tomx4096/hexidecimote/hardware/hdme/hdme_front.png

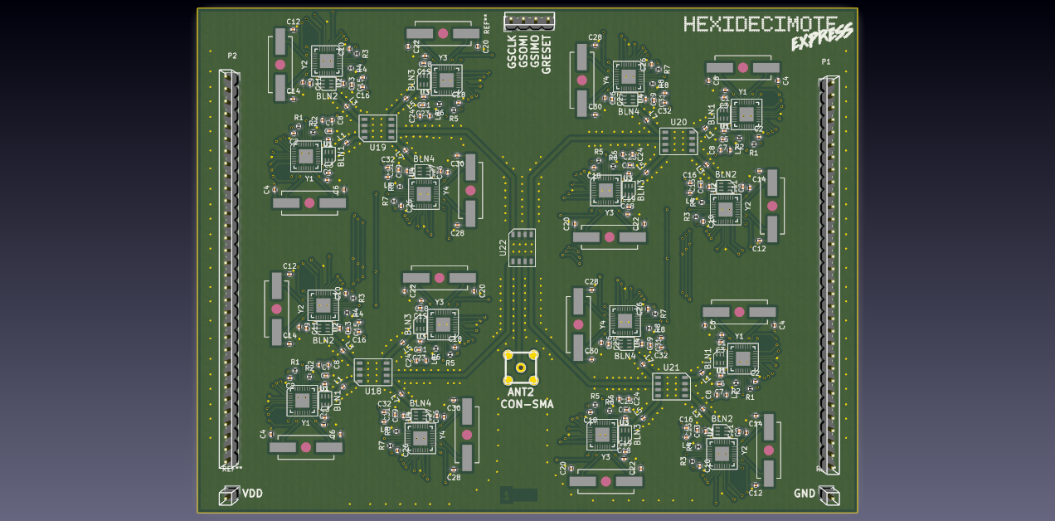
hardware/hdme/hdme_front.png
