tomx4096/hexidecimote/README.md

A device for passive interception of IEEE 802.15.4 packets in the 2.4 GHz band,
on multiple channels at the same time.

Designed in KiCad.
