tomx4096/hexidecimote/docs/multi_channel_wardriving.pdf

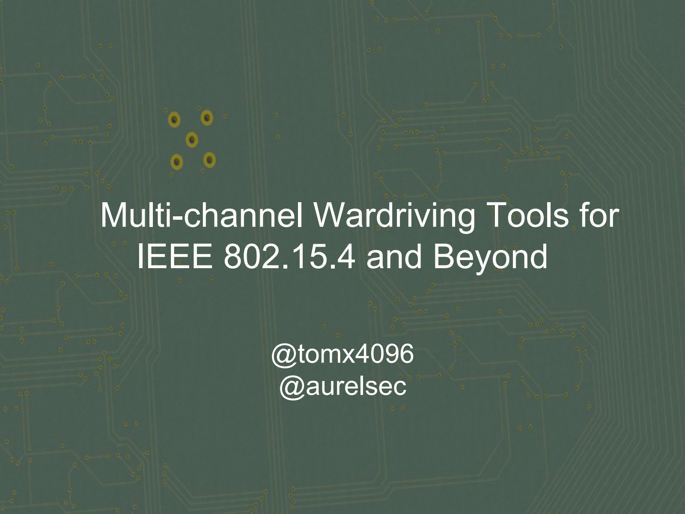
[picture p2: page 1]

# Multi-channel Wardriving Tools for IEEE 802.15.4 and Beyond

# @tomx4096 @aurelsec

# Plan:

# Chapter I: IEEE 802.15.4: Brief Primer & History

# Chapter II: Multi-channel, why, how and how not

# Chapter III: Tomorrow’s Designs, Soon

# Chapter I: IEEE 802.15.For Your Information

IEEE standard for PHY and MAC layers of Short Range,

# Low Rate, Wireless Networks

# (<10meters, 250kbps)

# Home and building automation, industrial

control, Healthcare, smart meters IoT..

# Chapter I: IEEE 802.15.For Your Information

IEEE standard for PHY and MAC layers of Short Range,

# Low Rate, Wireless Networks

# (<10meters, 250kbps)

# Home and building automation, industrial

control, Healthcare, smart meters IoT..

# Who uses this?

IEEE standard for PHY and MAC layers of Short Range,

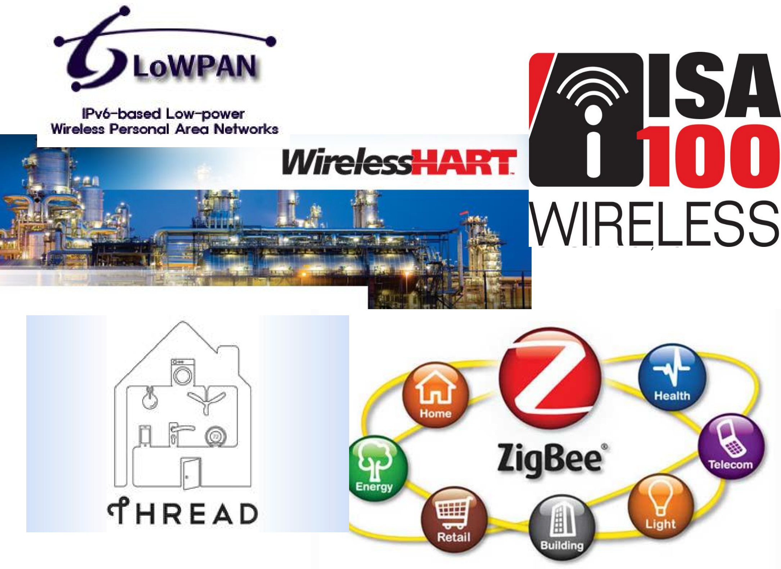
[picture p3: page 5]

Low Rate, Wireless Networks | (<10meters, 250kbps)

Home Automation, Industrial Control, IoT..

# IEEE 802.15.4 In the News

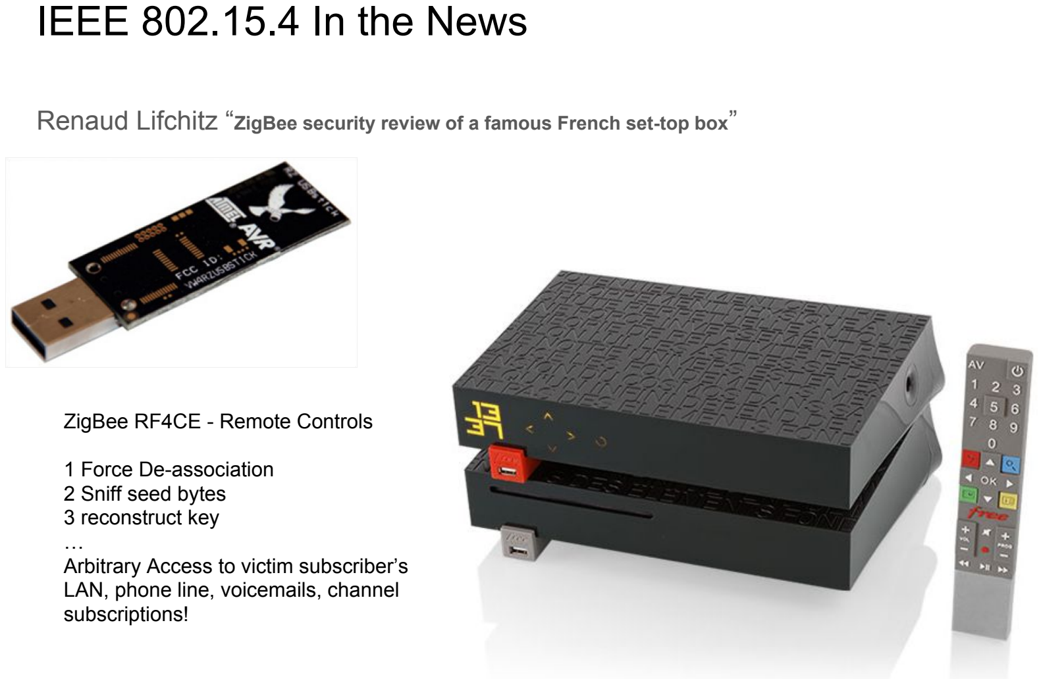
[picture p4: page 6]

Renaud Lifchitz “ZigBee security review of a famous French set-top box”

ZigBee RF4CE - Remote Controls

1 Force De-association
2 Sniff seed bytes
3 reconstruct key
…
Arbitrary Access to victim subscriber’s LAN, phone line, voicemails, channel subscriptions!

# IEEE 802.15.4 In the News

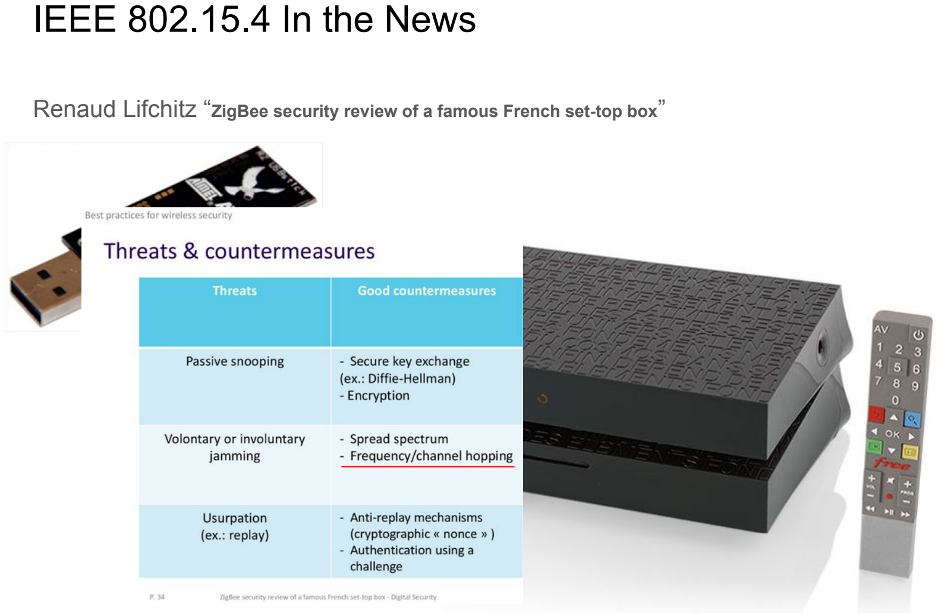
[picture p5: page 7]

Renaud Lifchitz “ZigBee security review of a famous French set-top box”

# Chapter I: IEEE 802.15.For Your Information

IEEE standard for PHY and MAC layers of Short Range,

# Low Rate, Wireless Networks

# (<10meters, 250kbps)

# Home and building automation, industrial

control, Healthcare, smart meters IoT..

# Why not 802.11? Why not bluetooth?

# IEEE 802.15.4 Features

## Simplicity <--> Good Economy ($, time and MWh)

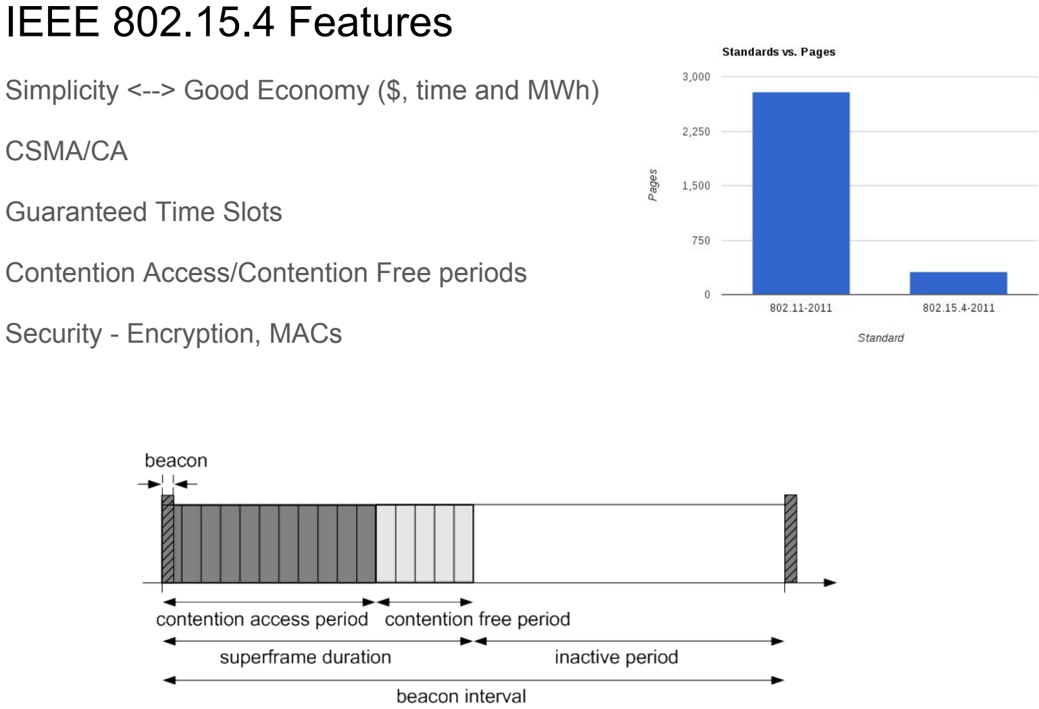
[picture p6: page 9]

## CSMA/CA

## Guaranteed Time Slots

## Contention Access/Contention Free periods

## Security - Encryption, MACs

# Chapter II: Multi-channel Motivation

## 1989 I want it all

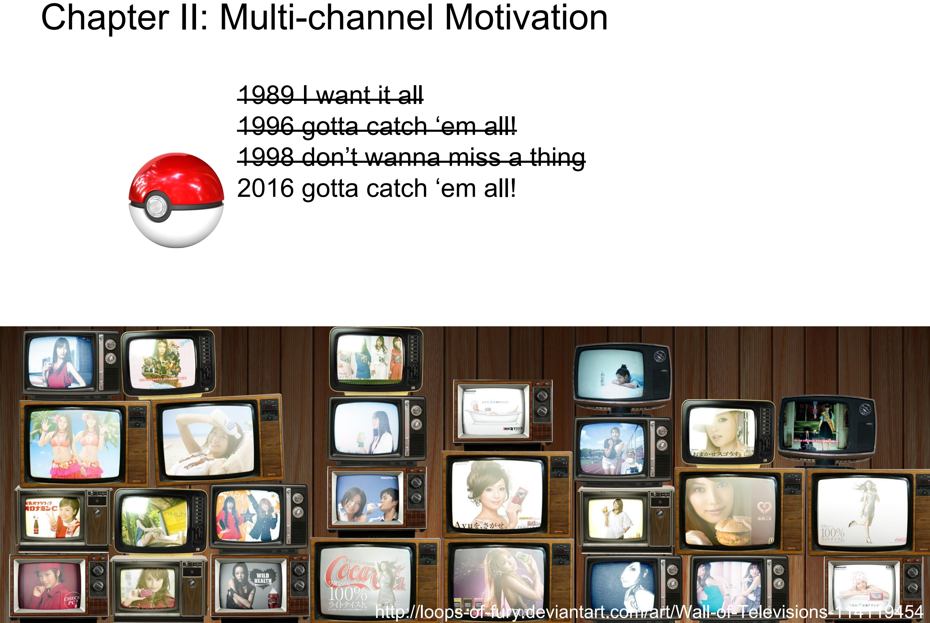
[picture p7: page 10]

http://loops-of-fury.deviantart.com/art/Wall-of-Televisions-114119454

## 1996 gotta catch ‘em all! 1998 don’t wanna miss a thing 2016 gotta catch ‘em all!

# Multi-channel Motivation

## Typical Wardriving Scenario:

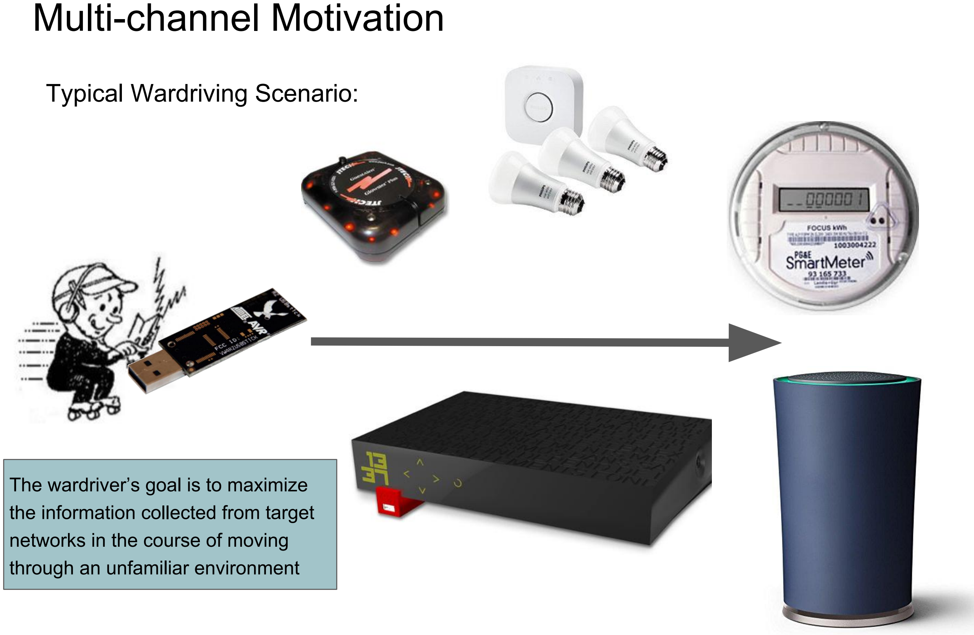
[picture p8: page 11]

http://loops-of-fury.deviantart.com/art/Wall-of-Televisions-114119454

The wardriver’s goal is to maximize the information collected from target networks in the course of moving through an unfamiliar environment

# Multi-channel Motivation

## Typical Wardriving Scenario:

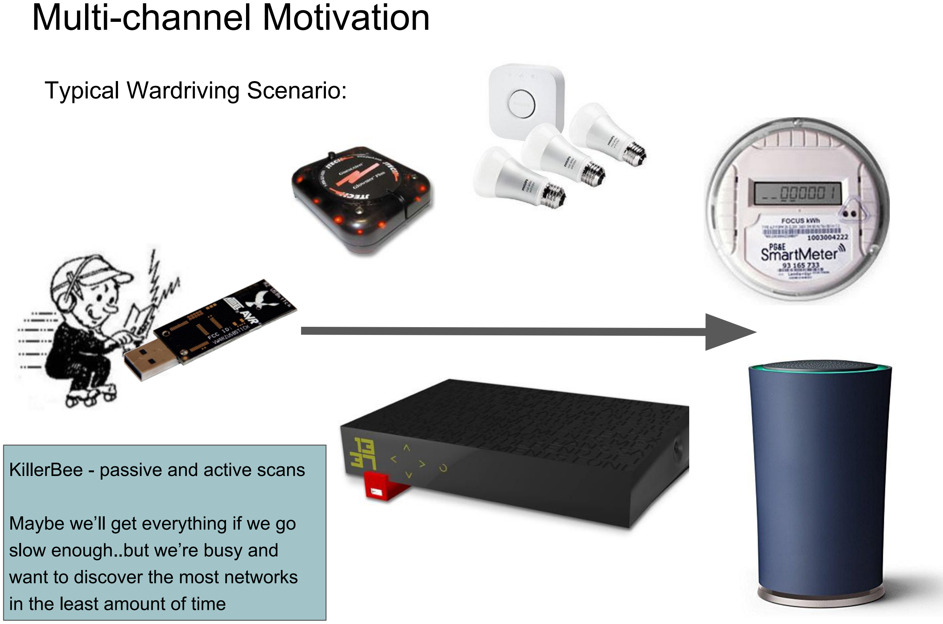
[picture p9: page 12]

http://loops-of-fury.deviantart.com/art/Wall-of-Televisions-114119454

KillerBee - passive and active scans

Maybe we’ll get everything if we go slow enough..but we’re busy and want to discover the most networks in the least amount of time

# Multi-channel Motivation:

http://loops-of-fury.deviantart.com/art/Wall-of-Televisions-114119454

# Low Rate wireless networks -> quieter protocols, fewer messages

# Mobility of wardrivers through short range -> Time spent “in range” is reduced

# Channel scanning -> Is NOT the most effective use of this limited time

# Channel hopping protocols -> Make our precious time even less effective!

## Every-channel sniffing improves our chance of stumbling upon new networks

# Multi-channel Motivation

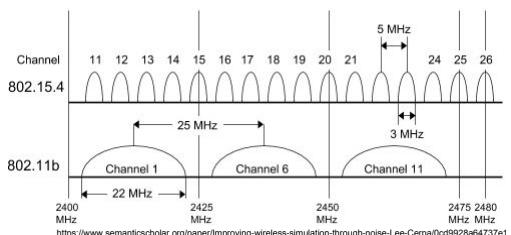
[picture p10: figure]

http://loops-of-fury.deviantart.com/art/Wall-of-Televisions-114119454https://www.semanticscholar.org/paper/Improving-wireless-simulation-through-noise-Lee-Cerpa/0cd9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

16 channels

80 MHz chunk of bandwidth

# What can we do?

## Build a cluster of receivers

## Use an SDR or a cluster of SDRs

## Build a new device

# Multi-channel Tradition

## Ban et al. (2007): Implementation of IEEE 802.15. 4 packet analyzer

## L. Choong (2009): Multi-channel IEEE 802.15. 4 packet capture using software defined radio

## Josh Wright. (2011): Killerbee: practical zigbee exploitation framework

## Speers et al. (2011): Api-do: Tools for Zig-Bee and 802.15. 4 Security Auditing

## Goodspeed et al. (2012): Api-do: Tools for exploring the wireless attack surface in smart meters

## Yoo et al. (2014): Multi-channel packet-analysis system based on IEEE 802.15. 4 packet-capturing modules

# What can we do?

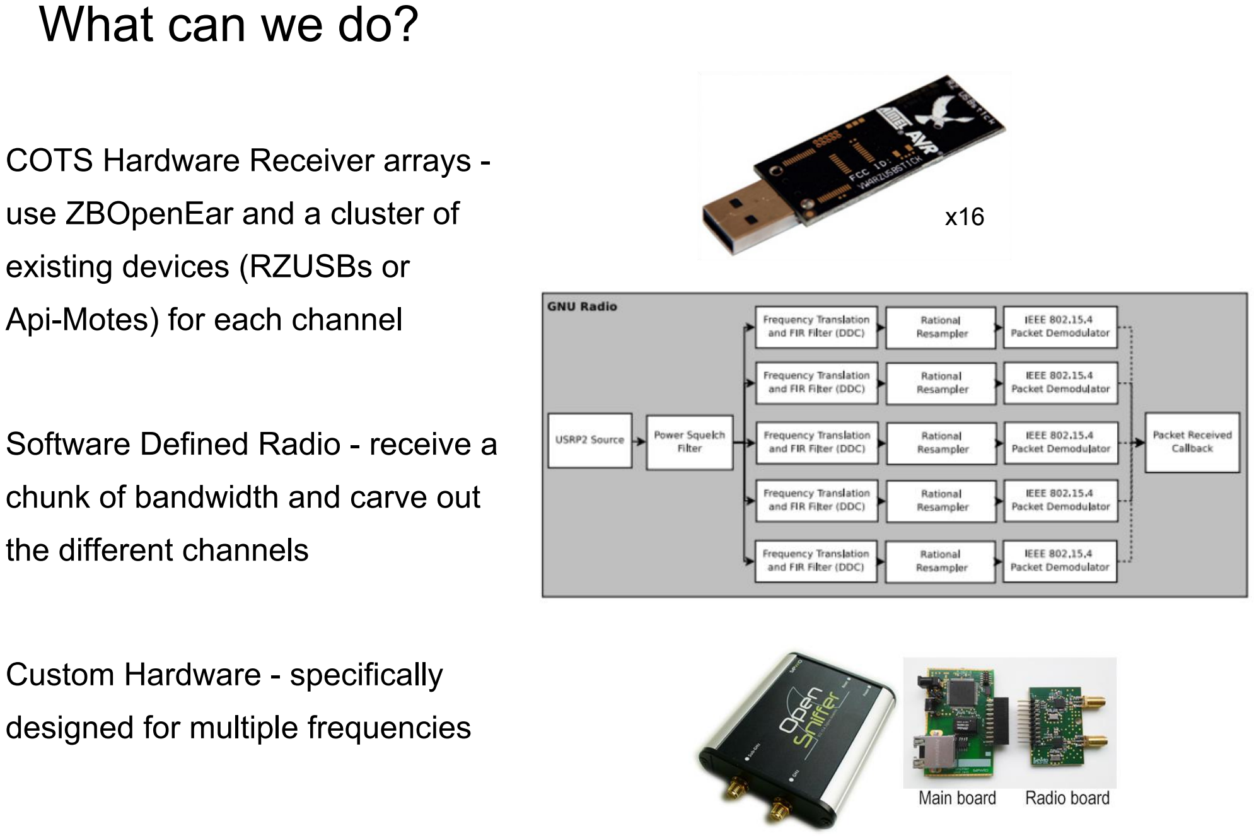
[picture p11: page 17]

## COTS Hardware Receiver arrays -

## use ZBOpenEar and a cluster of

## existing devices (RZUSBs or

## Api-Motes) for each channel

## Software Defined Radio - receive a

## chunk of bandwidth and carve out

## the different channels

## Custom Hardware - specifically

## designed for multiple frequencies

x16

# How about a hardware cluster?

## Simple, gets the job done

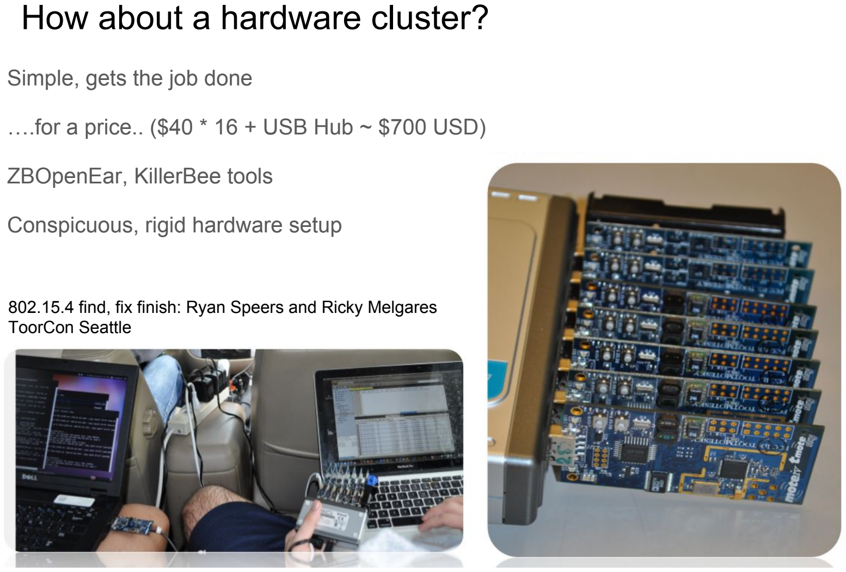
[picture p12: page 18]

## ….for a price.. ($40 * 16 + USB Hub ~ $700 USD)

## ZBOpenEar, KillerBee tools Conspicuous, rigid hardware setup

802.15.4 find, fix finish: Ryan Speers and Ricky Melgares ToorCon Seattle

# How about SDR?

Hopefully, one day..

## Analog-Digital Conversion is the weak link- dynamic range limits performance of the receiver

## Sampling ~80 MHz of bandwidth well enough to decode packets?

## Large computational effort to

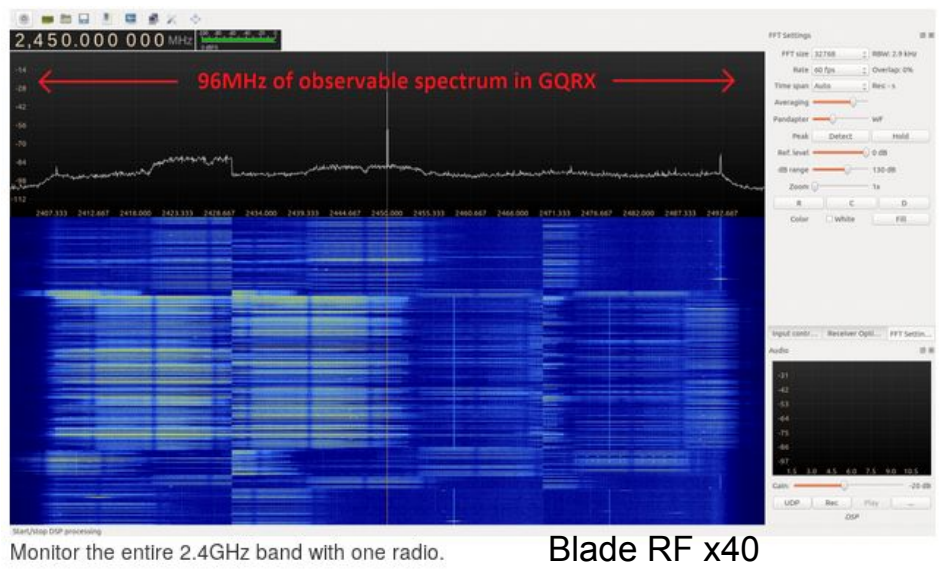
[picture p13: figure]
Blade RF x40

## demod packets

Cost, learning curve, power...

# Spot the SDRs

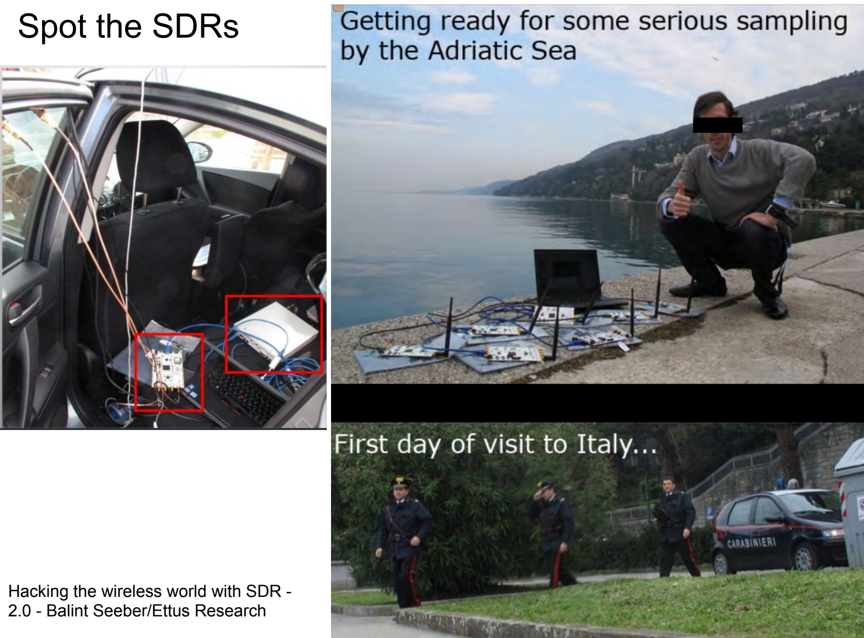
[picture p14: page 20]

Hacking the wireless world with SDR -2.0 - Balint Seeber/Ettus Research

# The GNURadio approach

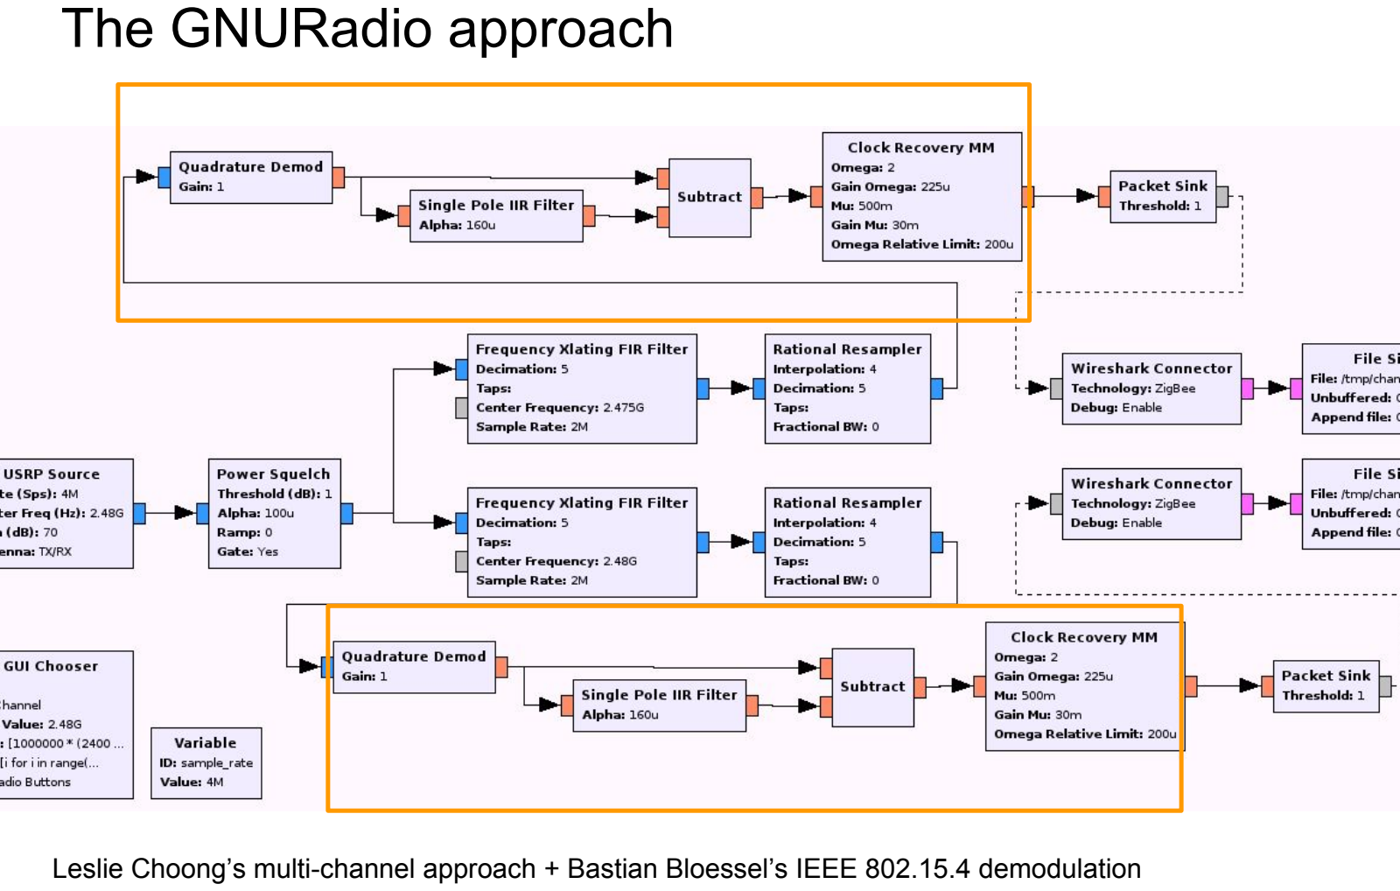
[picture p15: page 21]

Leslie Choong’s multi-channel approach + Bastian Bloessel’s IEEE 802.15.4 demodulation

# How about a new device?

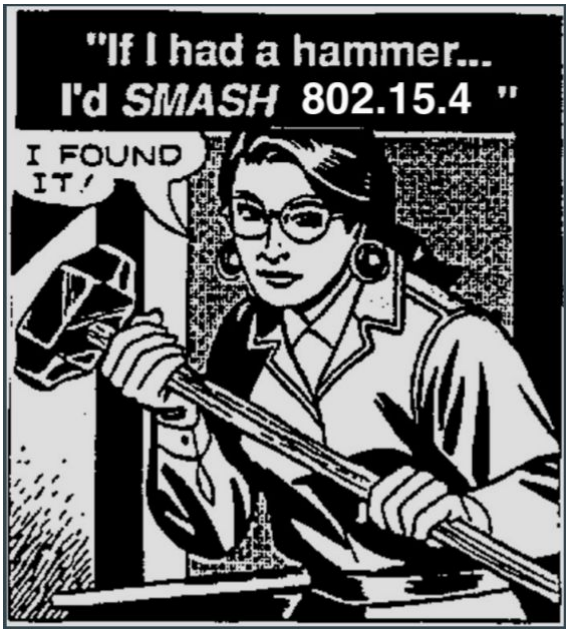
[picture p16: figure]

## Solutions in academic literature are often not portable/ hackable/open source (exception: Api-Mote)

Hardware clusters are big,

## expensive, power hungry

SDRs are big, clunky,

## expensive, power hungry, have a steep learning curve, and limited performance in some cases

# Chapter III: Goals for a new design:

## DG1. Complete simultaneous coverage Parallel reception of all 16 channels of the 2.4 GHz 802.15.4 band

## DG2. Easy to use No learning curve beyond "Plug it in and run KillerBee tools"

## DG3. Relatively cheap The price to beat is 16 RZUSBs + USB hubs

## DG4. Portable and discreet One piece, one antenna, fits in a shoe box, will not capture the wrong attention

## DG5. Extensible

Accommodates peripherals like GPS, WiFi, SD card, etc.

## DG6. Robust performance Good reception indoors, outdoors, with Wifi/Bluetooth interference

## Properties of 802.15.4 multi-channel sniffers

# Api-mote v4 Design

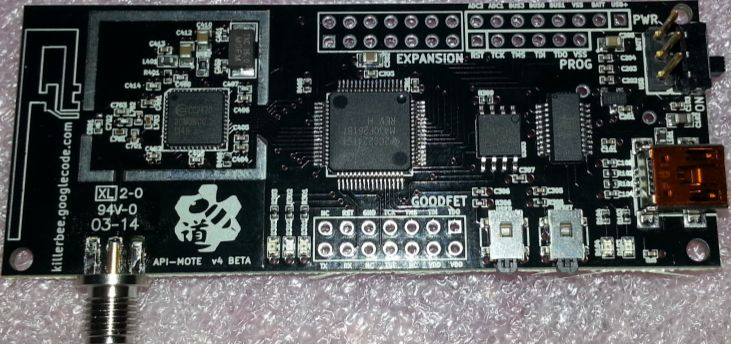
[picture p17: figure]

CC2420 radio Api-mote v4 Design OBSOLETED | On the board but not used by firmware! 10mA active, 5 uA standby

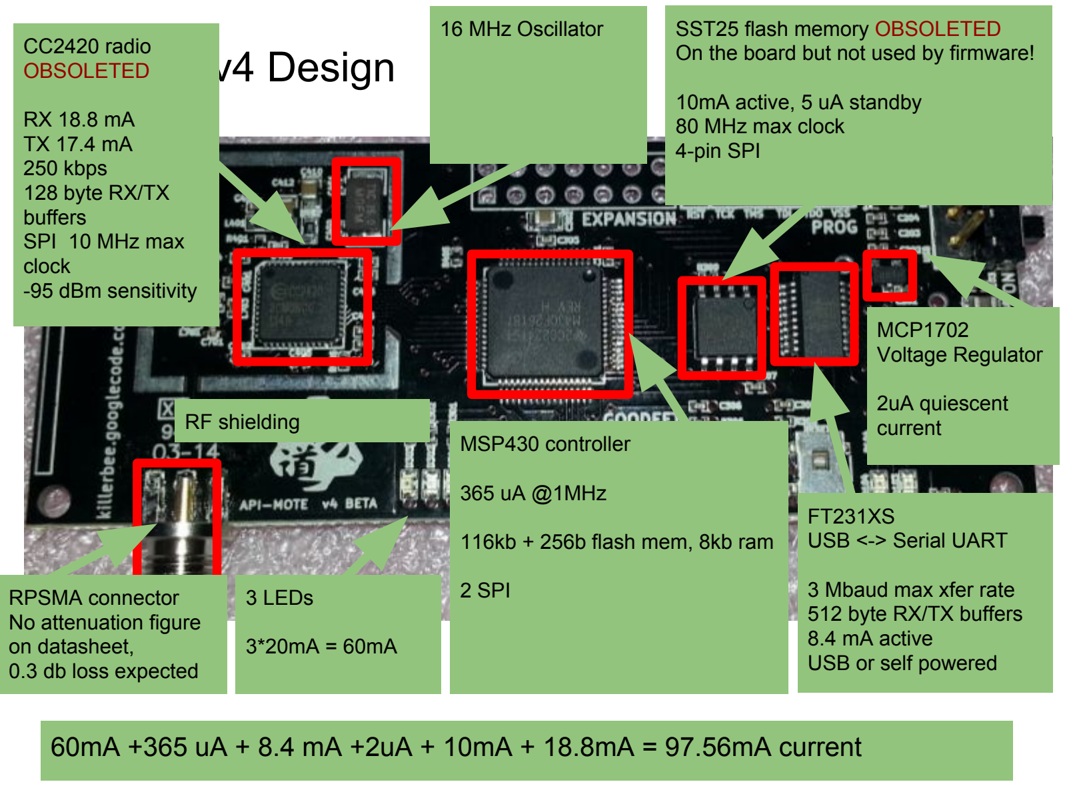
[picture p18: page 26]

| 80 MHz max clock
TX 17.4 mA 250 kbps 128 byte RX/TX buffers SPI 10 MHz max clock -95 dBm sensitivity | 4-pin SPI

RPSMA connector
No attenuation figure
on datasheet,
0.3 db loss expected

RX 18.8 mA

MSP430 controller

365 uA @1MHz

116kb + 256b flash mem, 8kb ram

2 SPI

16 MHz Oscillator | SST25 flash memory OBSOLETED

FT231XS
USB <-> Serial UART

3 Mbaud max xfer rate
512 byte RX/TX buffers
8.4 mA active
USB or self powered

MCP1702
Voltage Regulator

2uA quiescent
current

3 LEDs

3*20mA = 60mA

RF shielding

## 60mA +365 uA + 8.4 mA +2uA + 10mA + 18.8mA = 97.56mA current

# Api-Mote v4 design

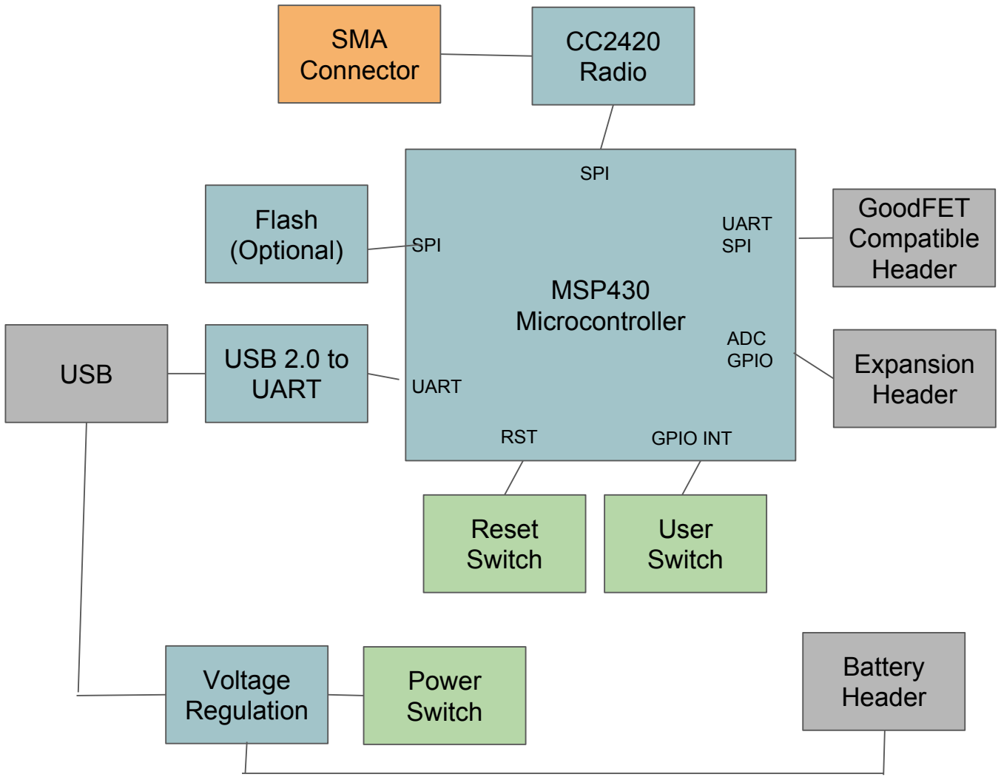
[picture p19: figure]
MSP430 Microcontroller; Flash (Optional); USB 2.0 to UART USB; Voltage Regulation; Power Switch; Reset Switch; User Switch; RST; GPIO INT; Battery Header; Expansion Header; GoodFET Compatible Header; UART SPI; ADC GPIO; UART; SPI; CC2420 Radio; SMA Connector

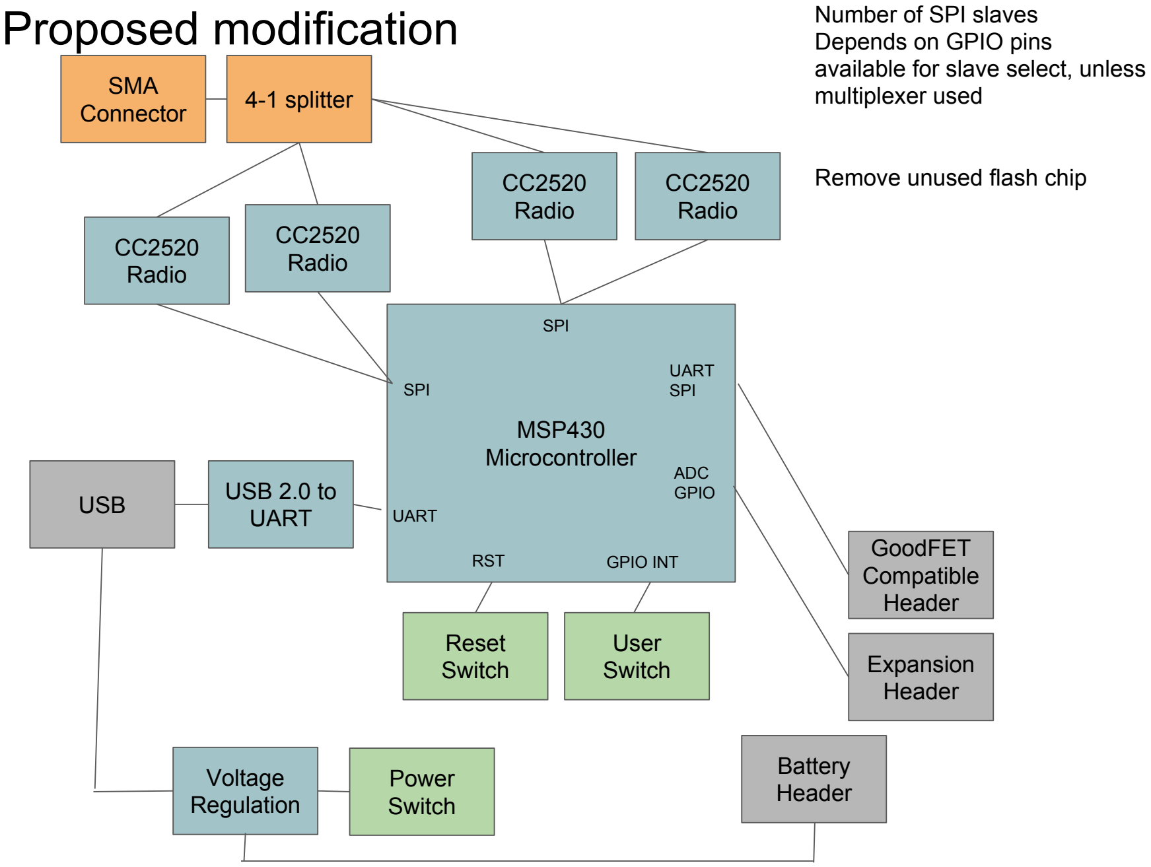
[picture p20: figure]
Proposed modification; MSP430 Microcontroller; USB 2.0 to UART USB; Voltage Regulation; Power Switch; Reset Switch; User Switch; RST; GPIO INT; Battery Header; Expansion Header; GoodFET Compatible Header; UART SPI; ADC GPIO; UART; SPI; CC2520 Radio; SMA Connector; CC2520 Radio CC2520 Radio; Number of SPI slaves Depends on GPIO pins available for slave select, unless multiplexer used; Remove unused flash chip; 4-1 splitter

# Express Design

# How can this be simplified?

# Delegate non-radio functionality to devices off of the board and provide an interface to the radios alone

# Remove microprocessor, USB, JTAG connector, and amplifier. This is the user’s responsibility now!

# More extensible/modular Cheaper to produce Simpler, mitigates risk of catastrophic design mistakes

# Express Design

# How can this be simplified?

# Delegate non-radio functionality to devices off of the board and provide an interface to the radios alone

# Remove microprocessor, USB, JTAG connector, and amplifier. This is the user’s responsibility now!

# More extensible/modular Cheaper to produce Simpler, mitigates risk of catastrophic design mistakes

## Michael Ossmann: Simple RF Circuit Design

## https://www.youtube.com/watch?v=TnRn3Kn_aXg

# RF View:

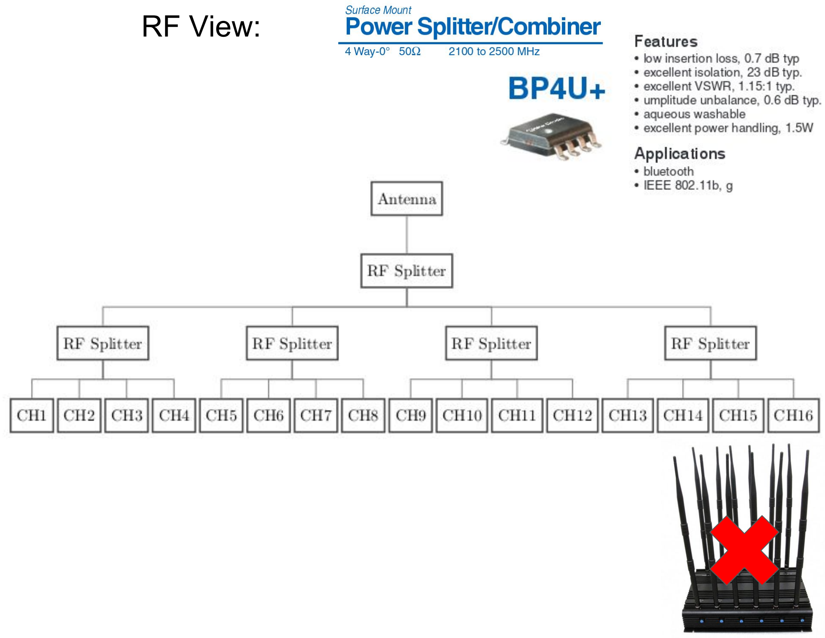
[picture p21: page 31]

# Digital View:

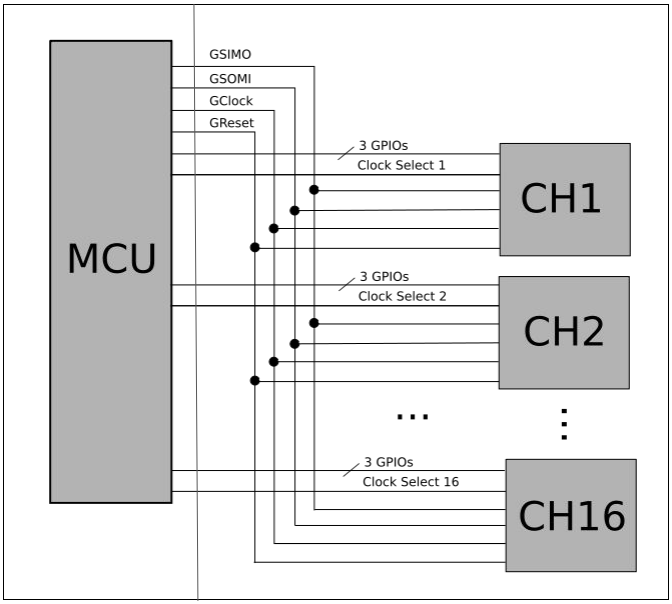
[picture p22: figure]
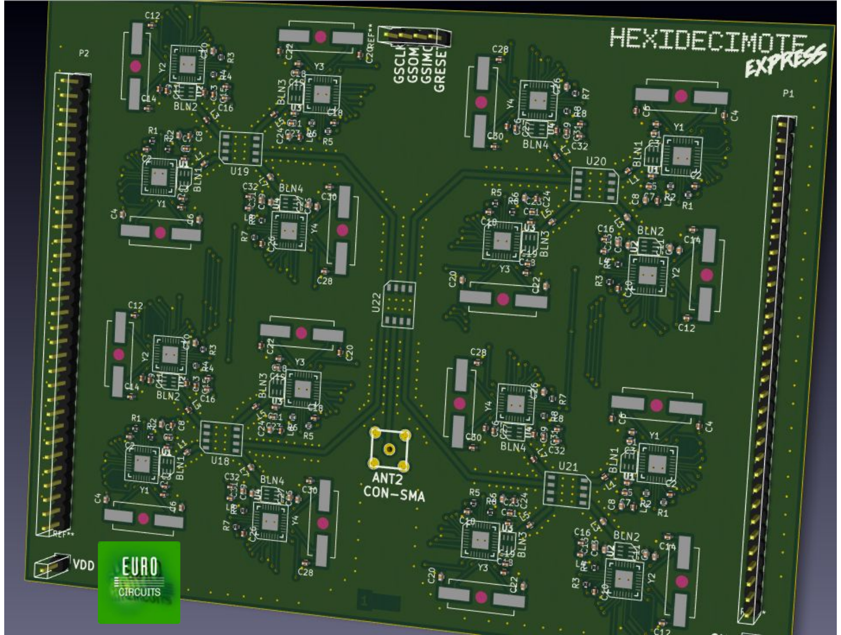
[picture p23: page 33]

# Device Design R3

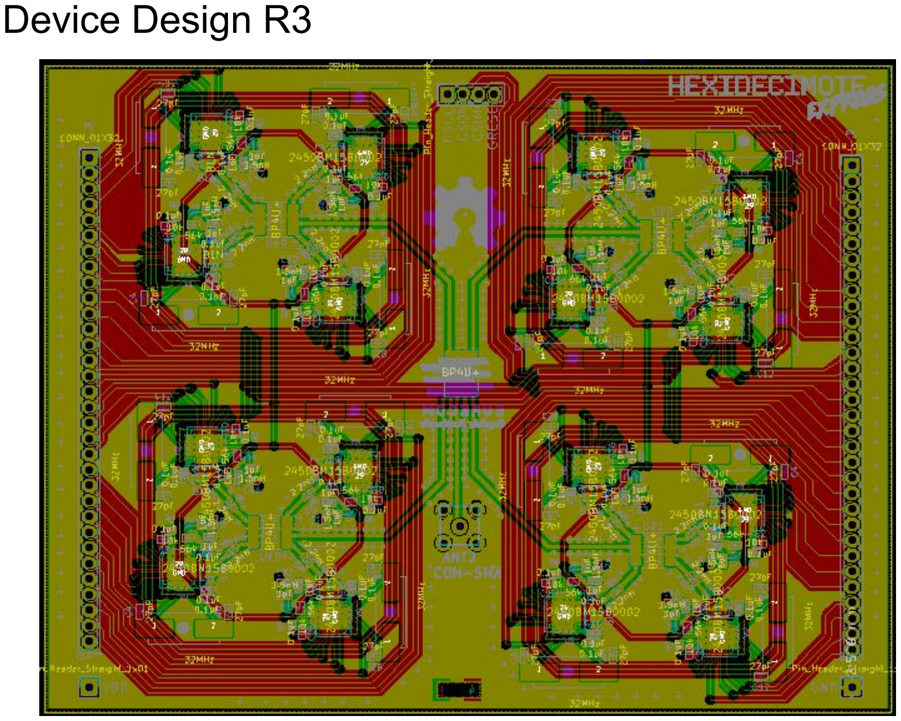
[picture p24: page 34]

# HDME + BBB

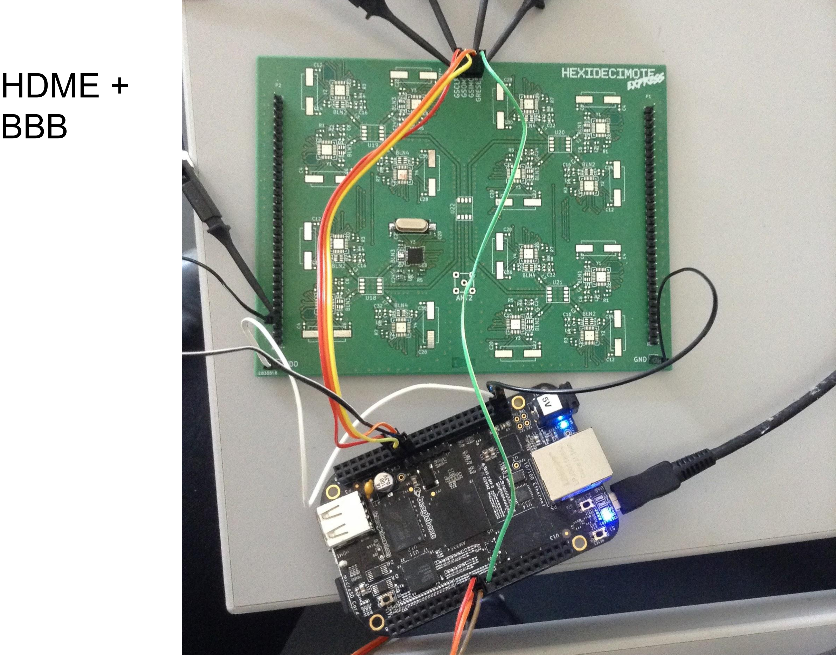
[picture p25: page 35]

# Only 6.25% completion

## 1/16 radios soldered✓

## SPI (CC2520 driver in linux kernel)✓

## wpan-tools compatibility ✓

## ….please contribute!

## github.com/tomx4096

## Packet reception X

## Multi-radio driver X

## Performance testing X

## BBB “cape” form factor X

# Thank you, village people

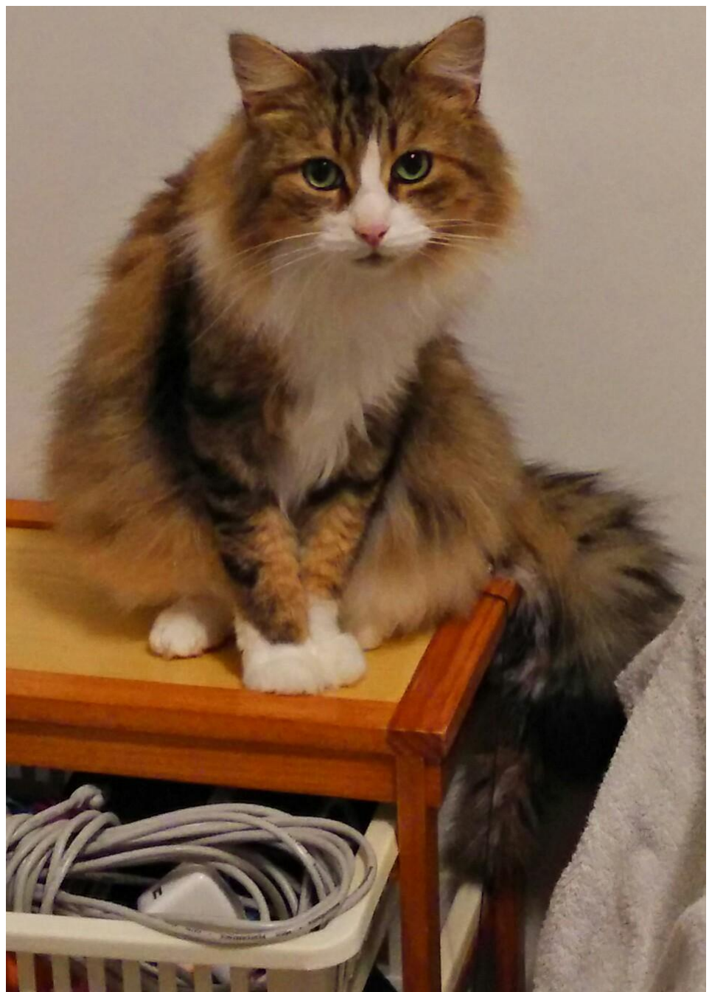
[picture p26: figure]

# Standard and Amendments

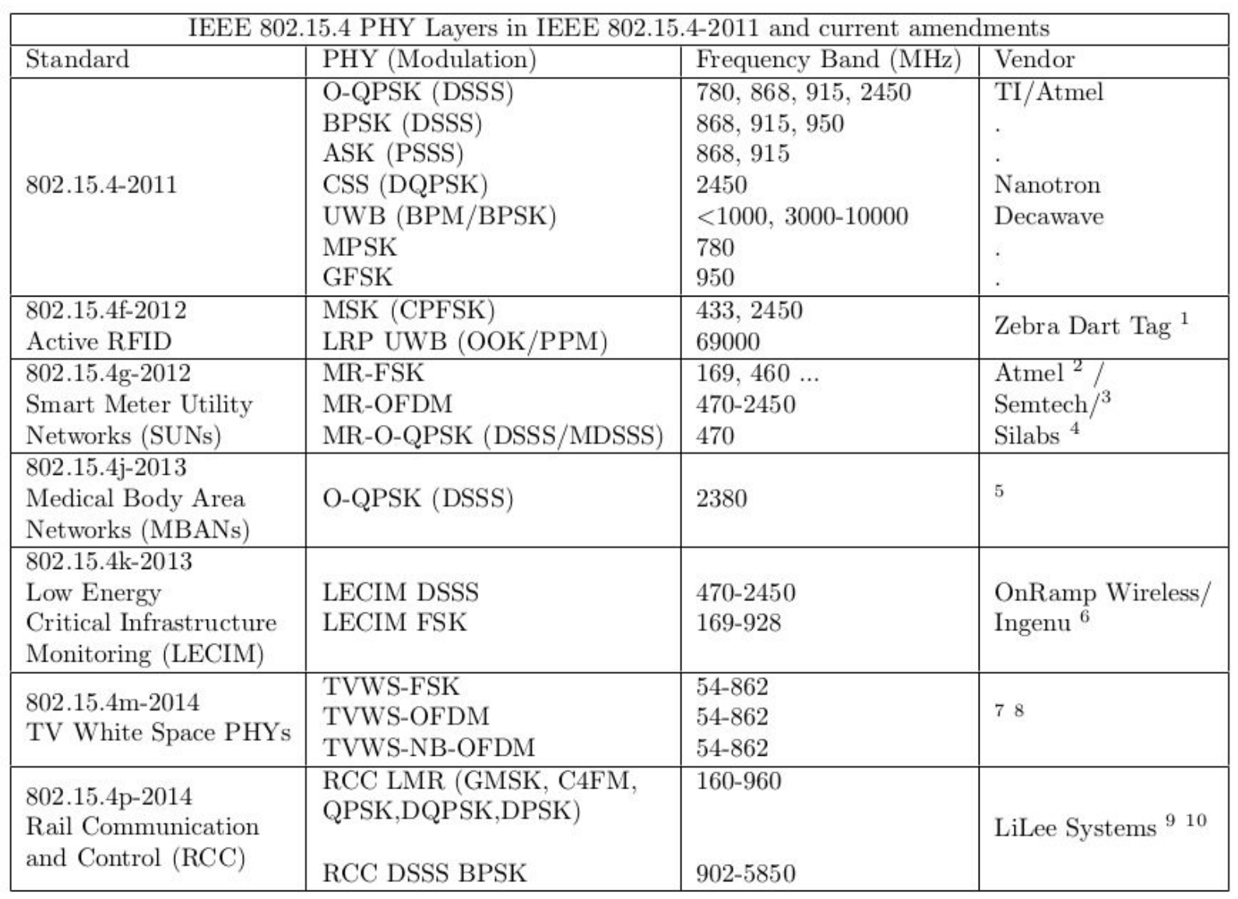
[picture p27: page 38]
