tomx4096/hexidecimote/hardware/hdme/hdme_back.png

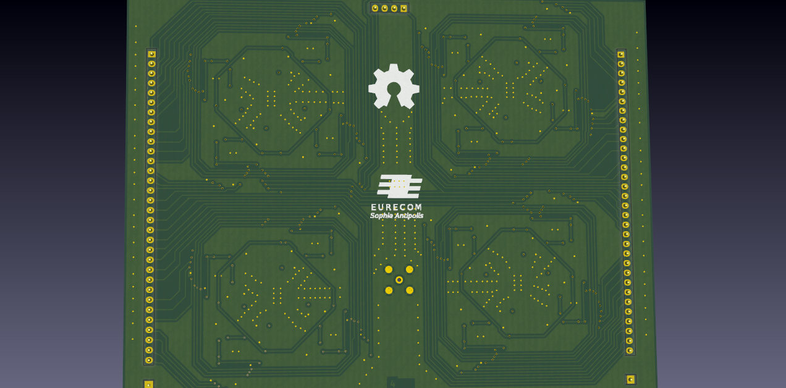
hardware/hdme/hdme_back.png
