tomx4096/hexidecimote/hardware/hdme/hdme.sch

## KiCad design hardware/hdme/hdme.sch (2016-08-08)

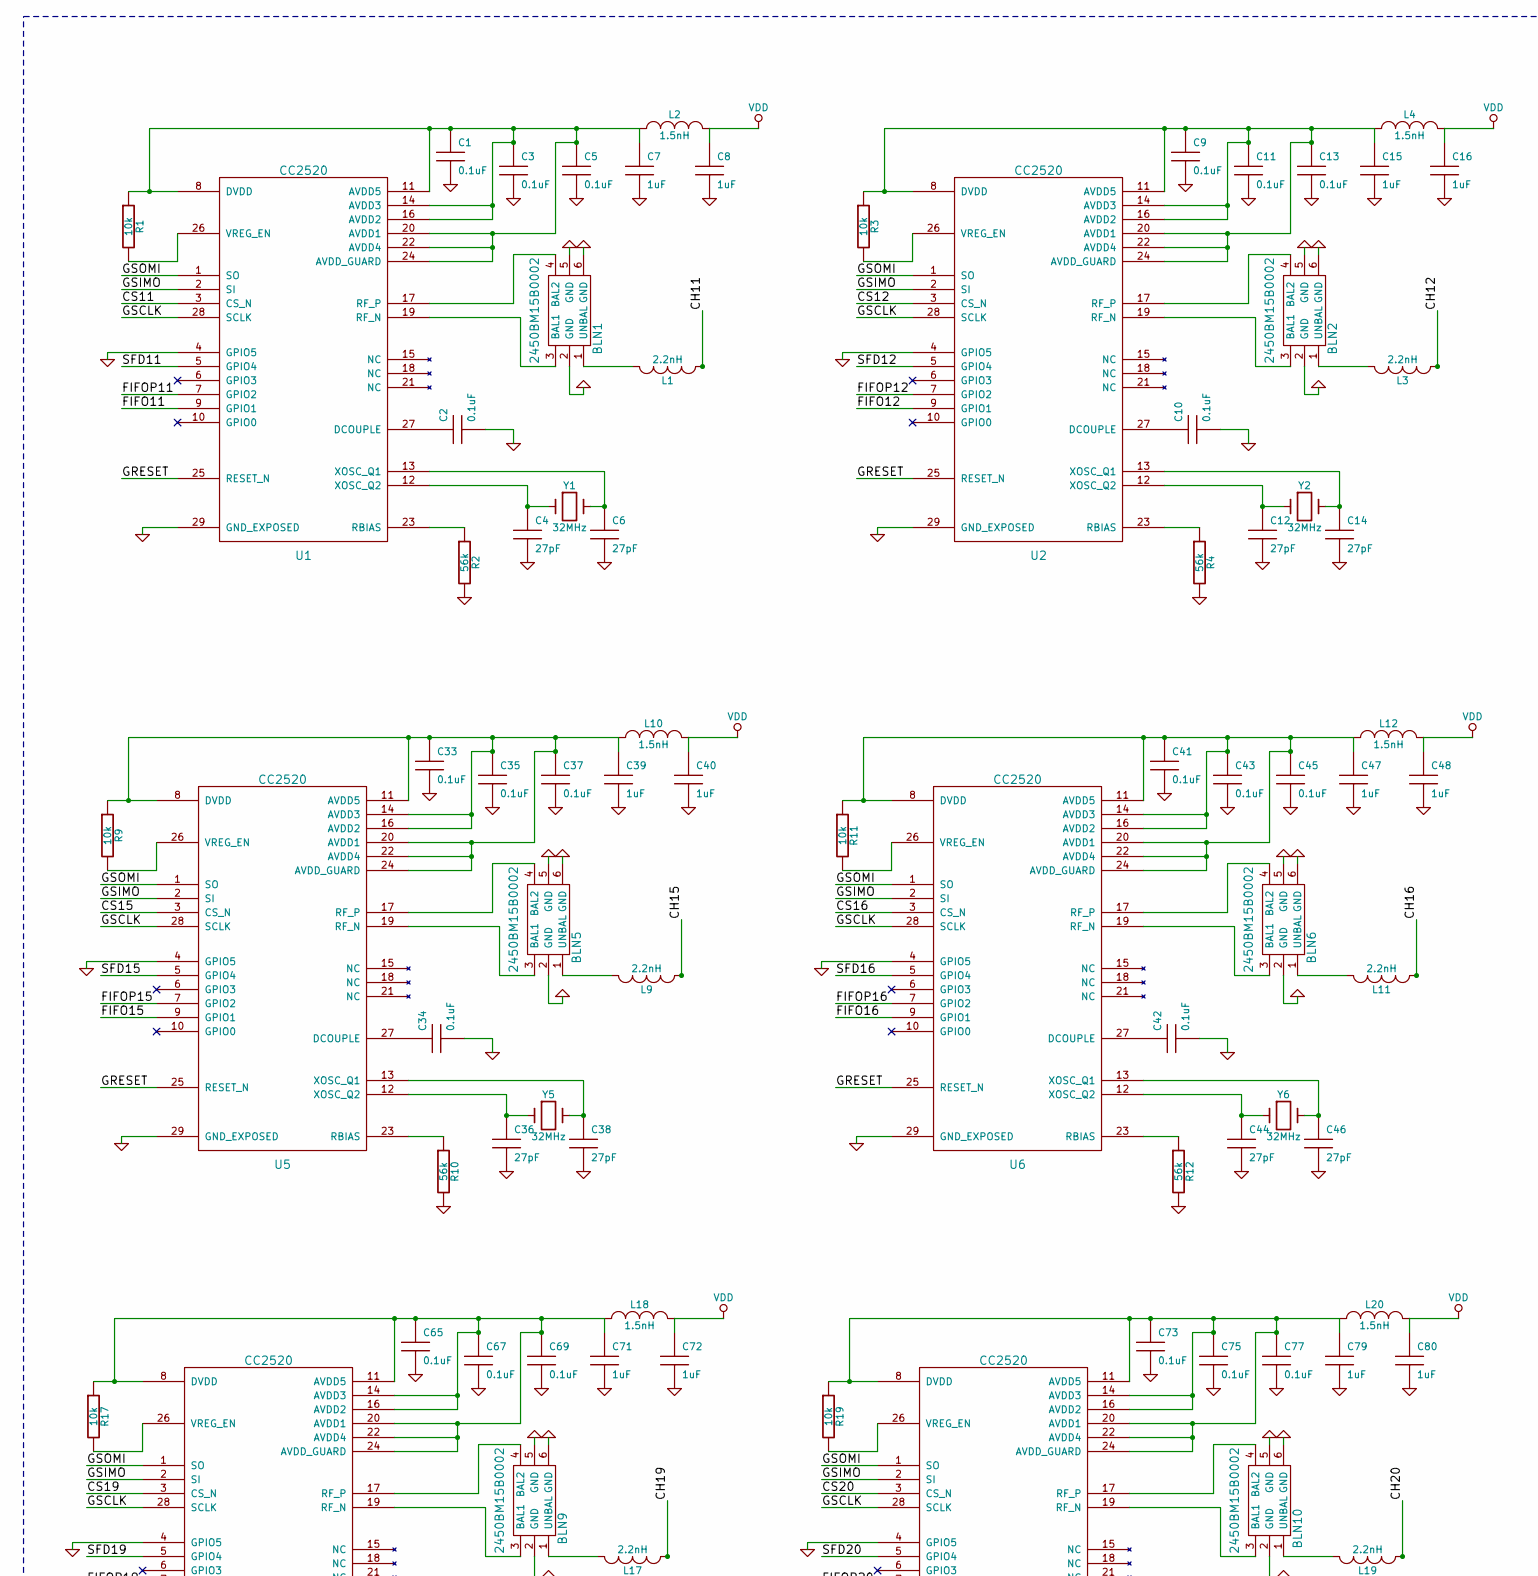
[picture p29: schematic hdme.sch, part in row 1, column 1]

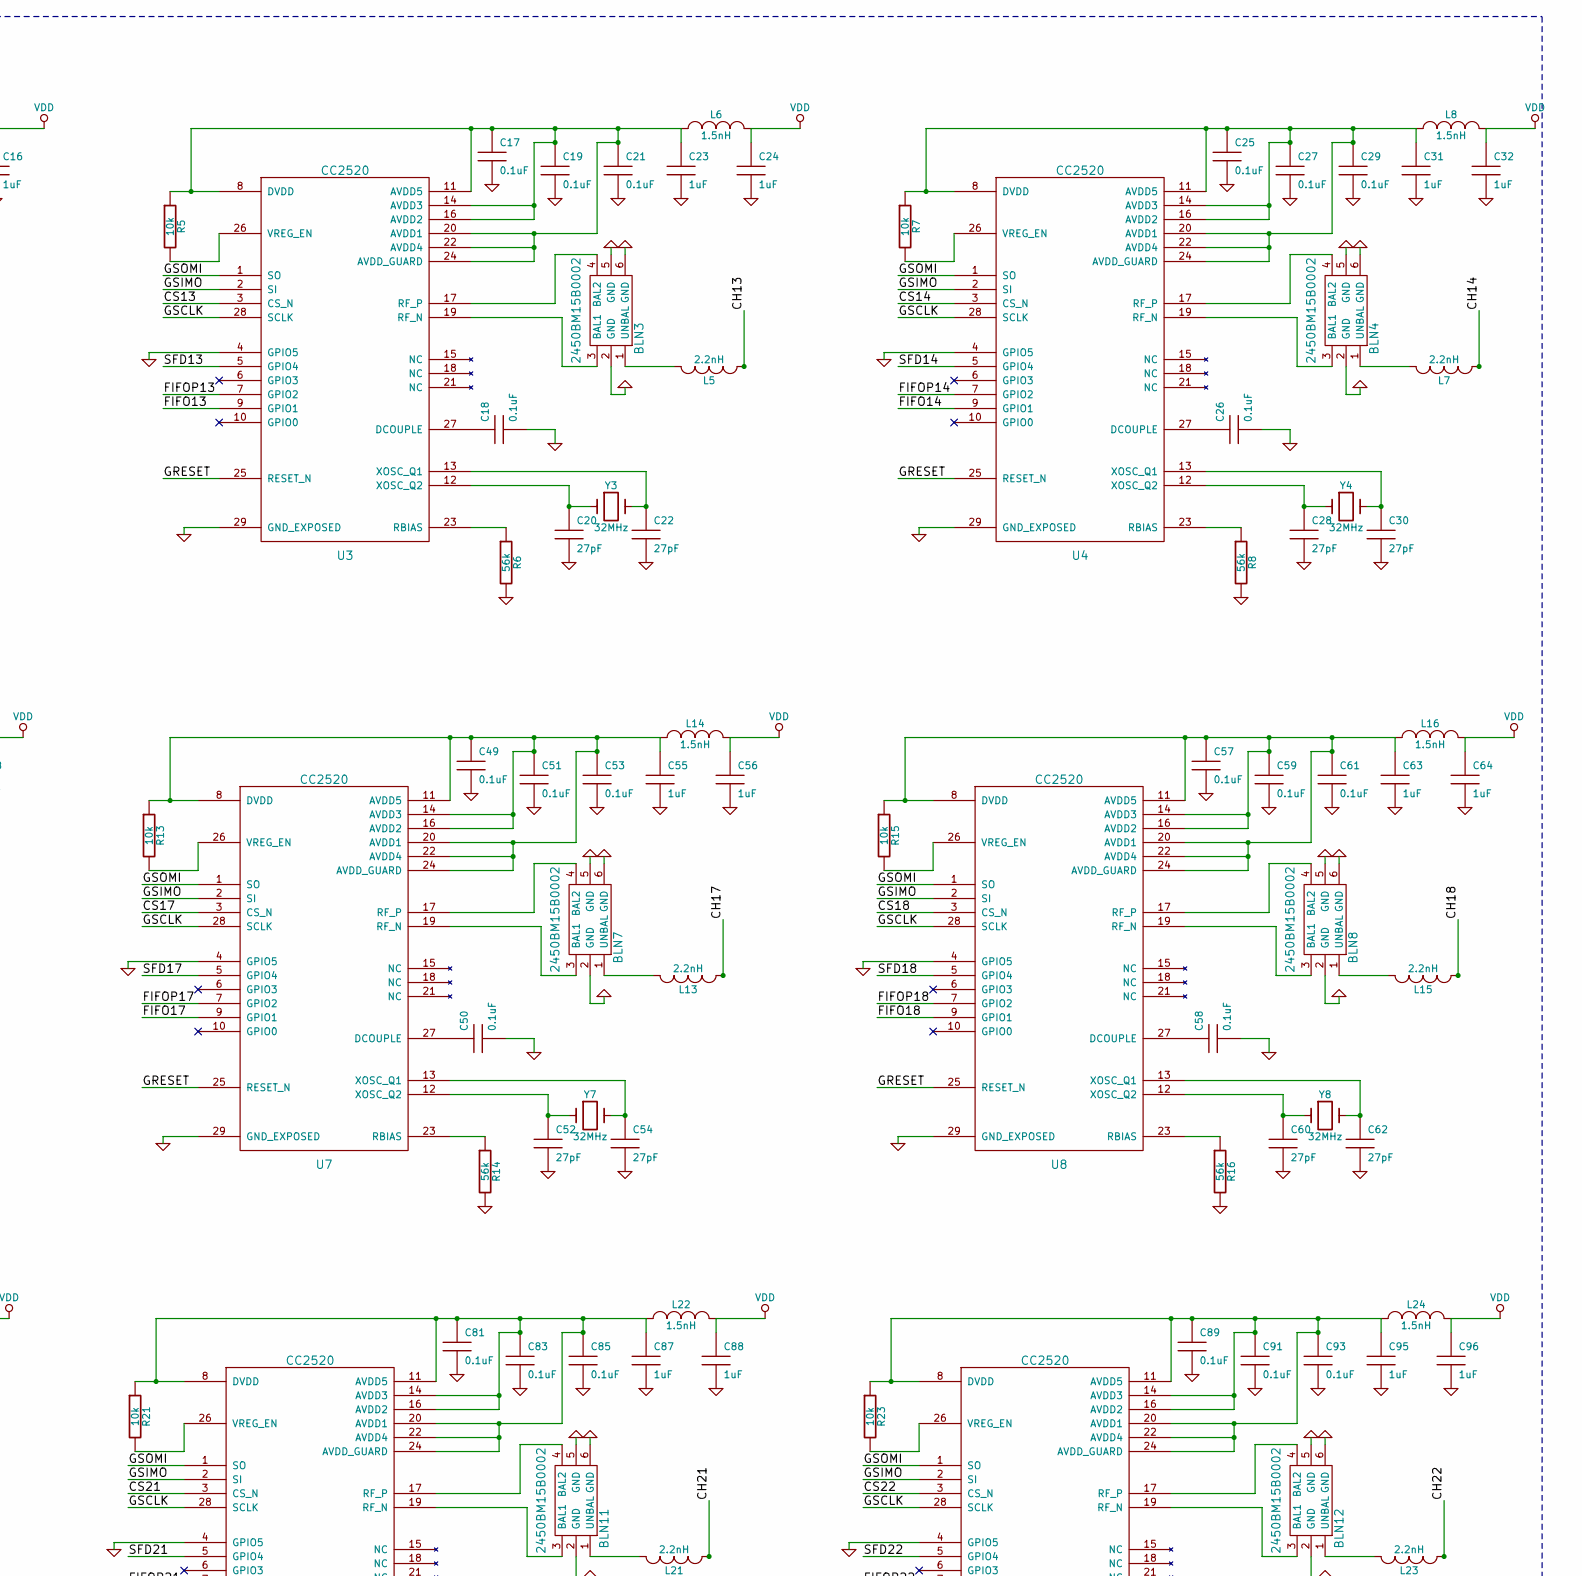
[picture p30: schematic hdme.sch, part in row 1, column 2]

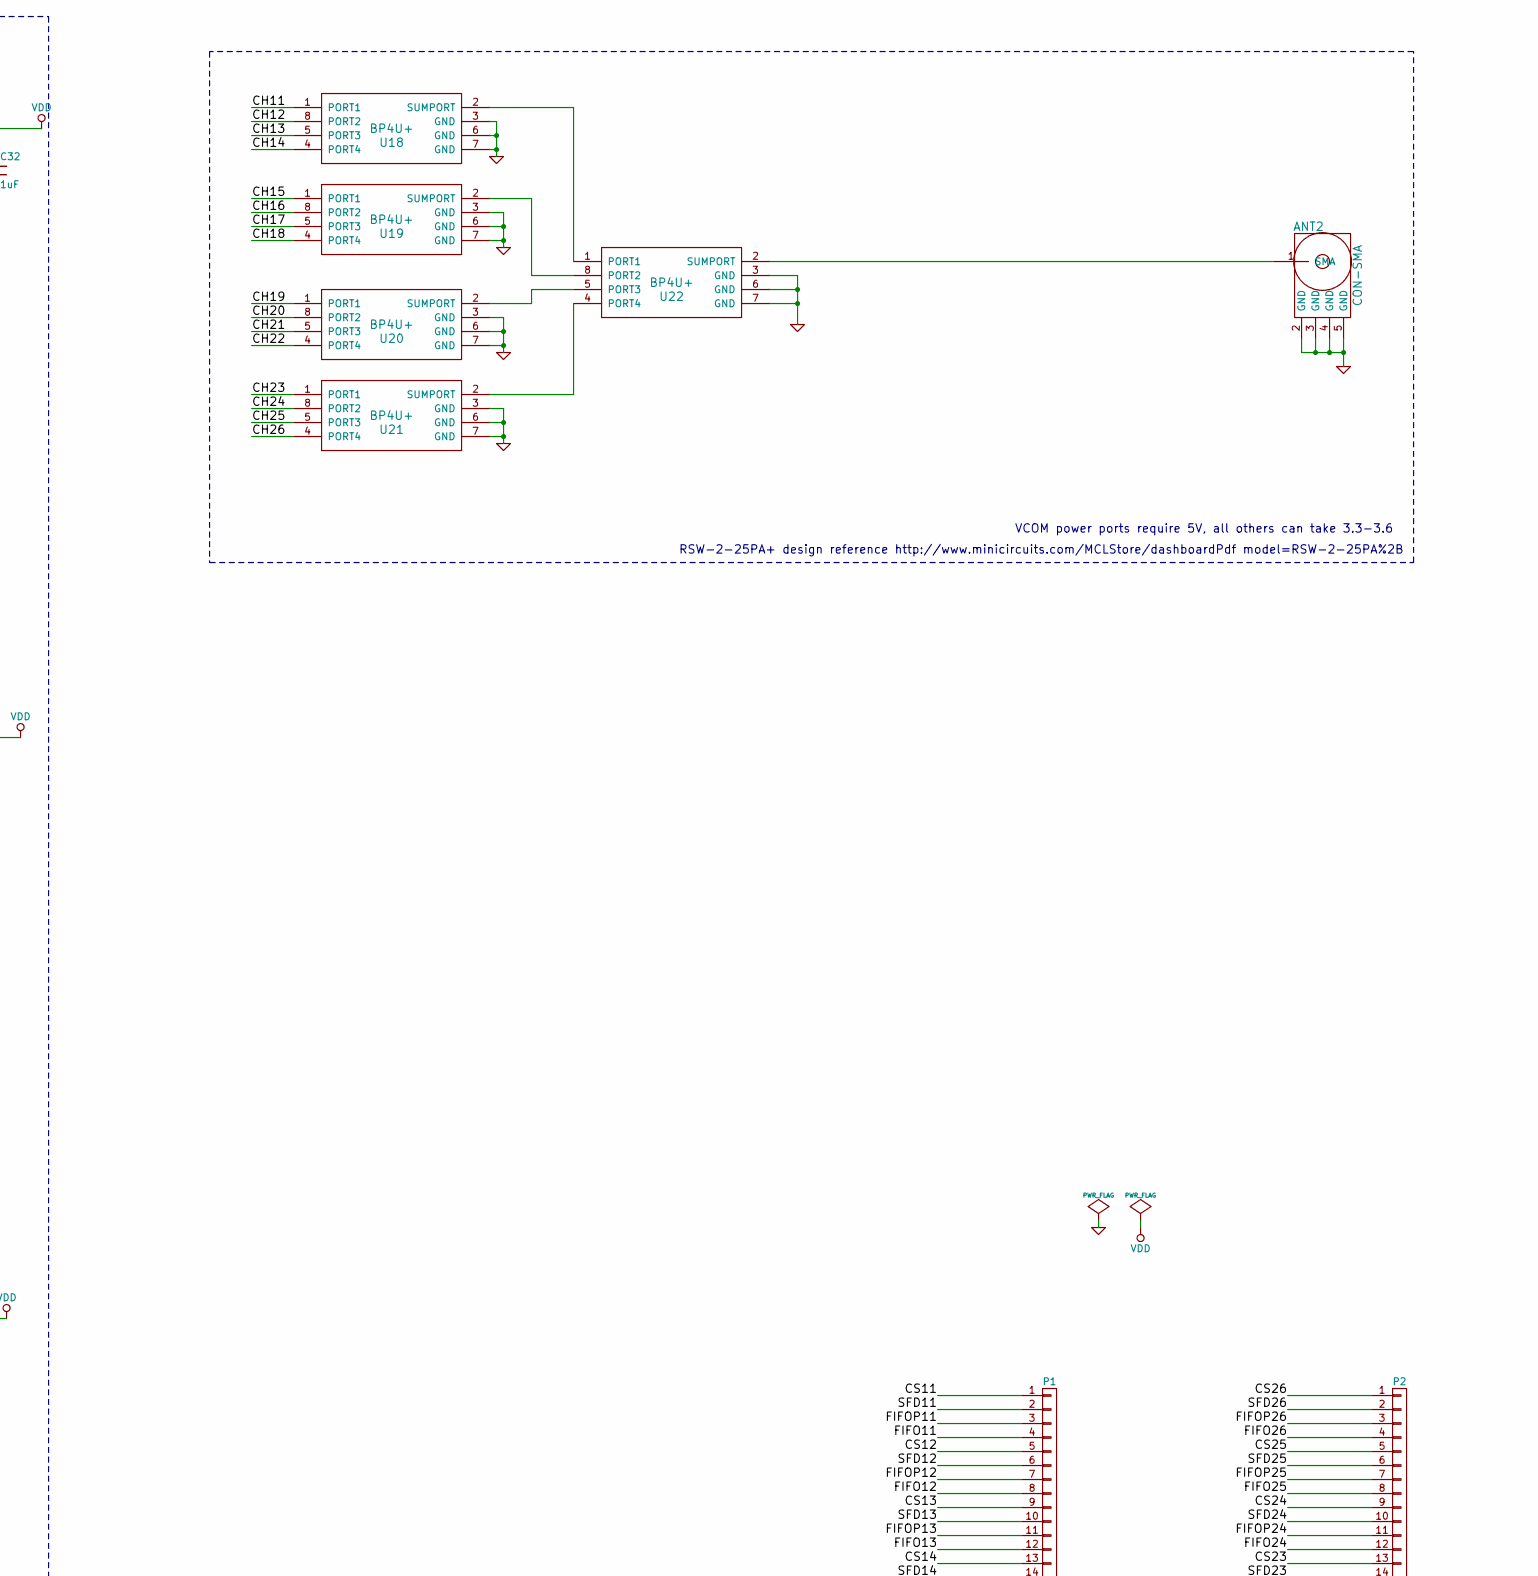
[picture p31: schematic hdme.sch, part in row 1, column 3]

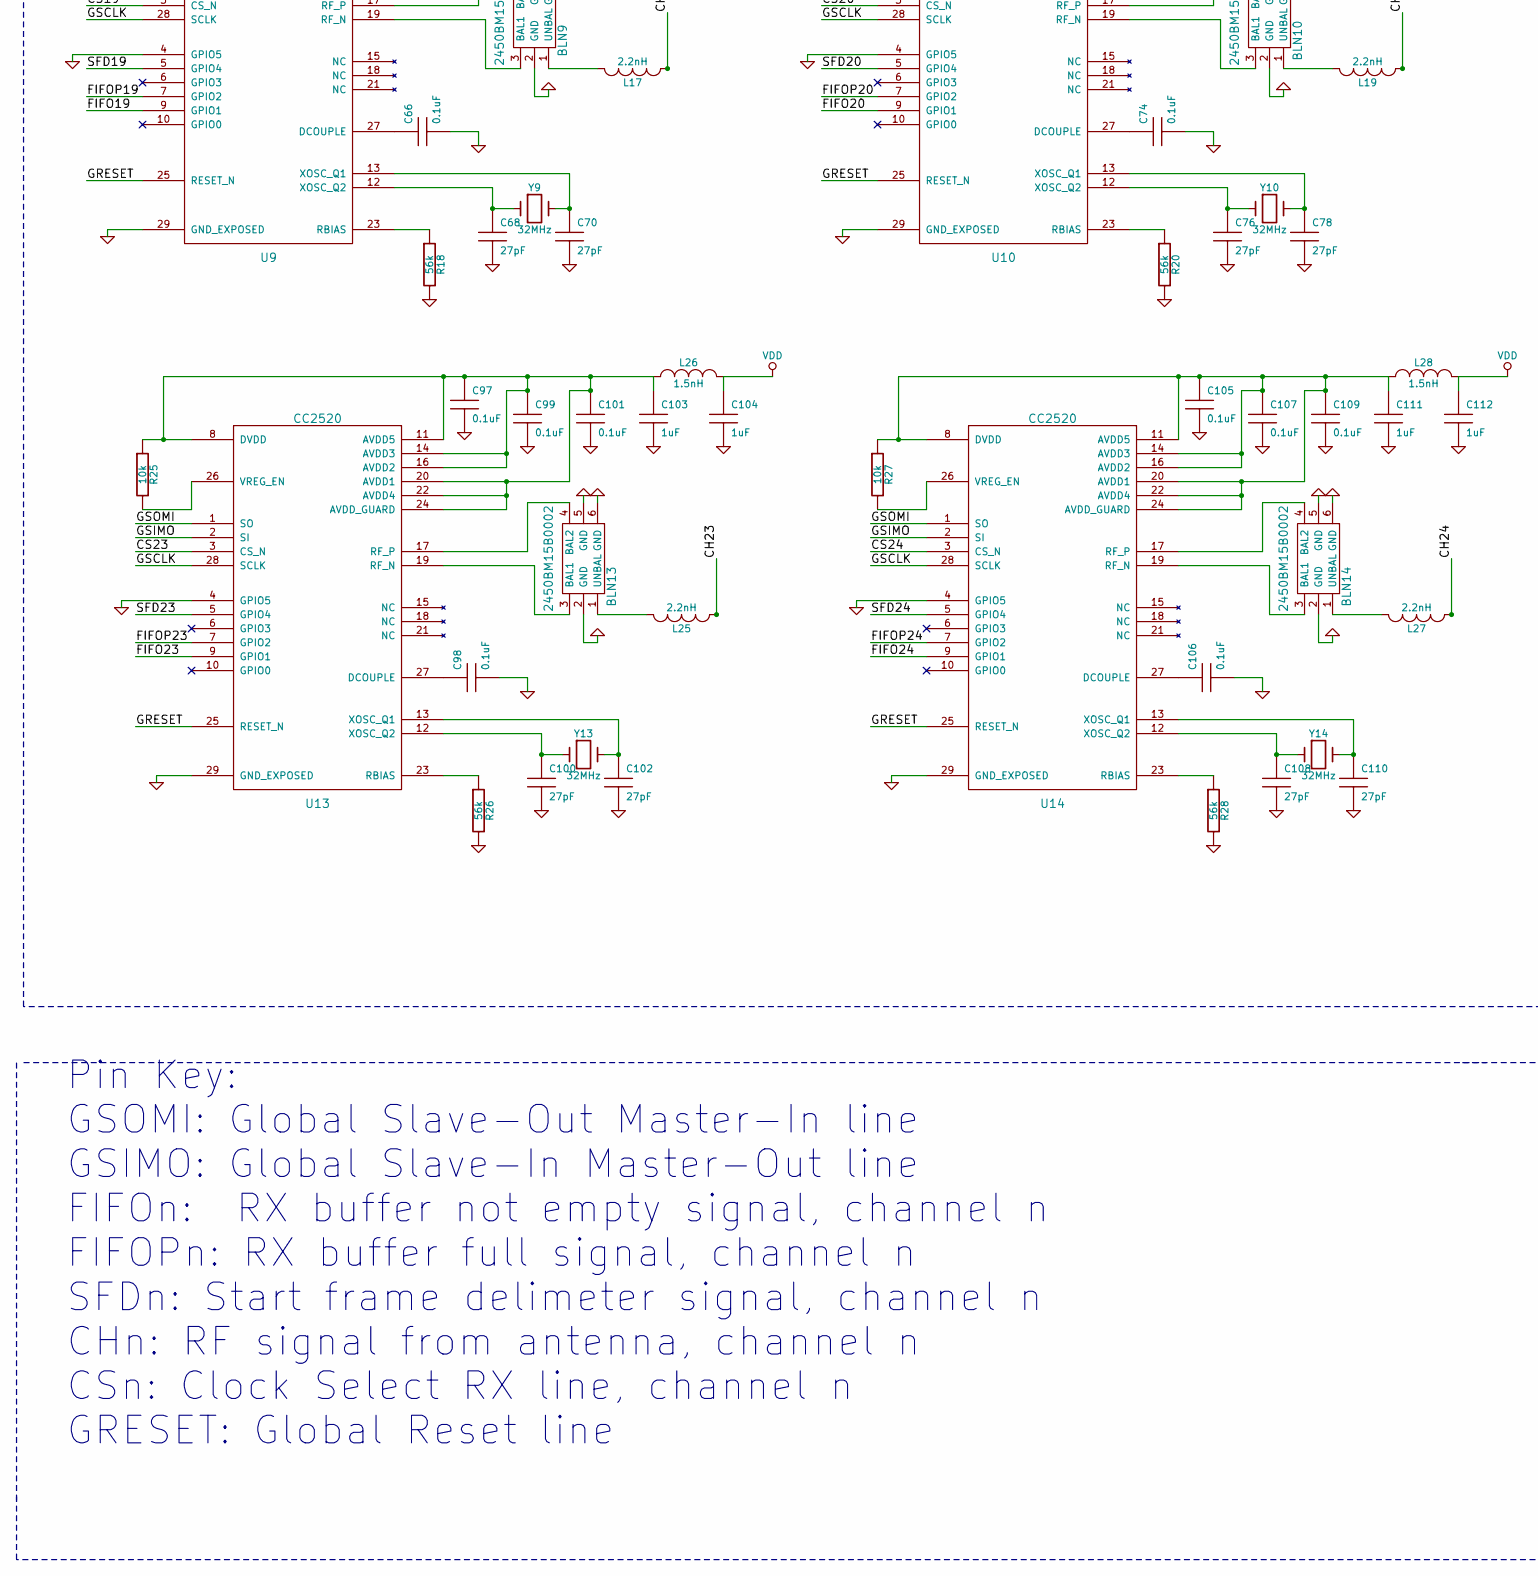
[picture p32: schematic hdme.sch, part in row 2, column 1]

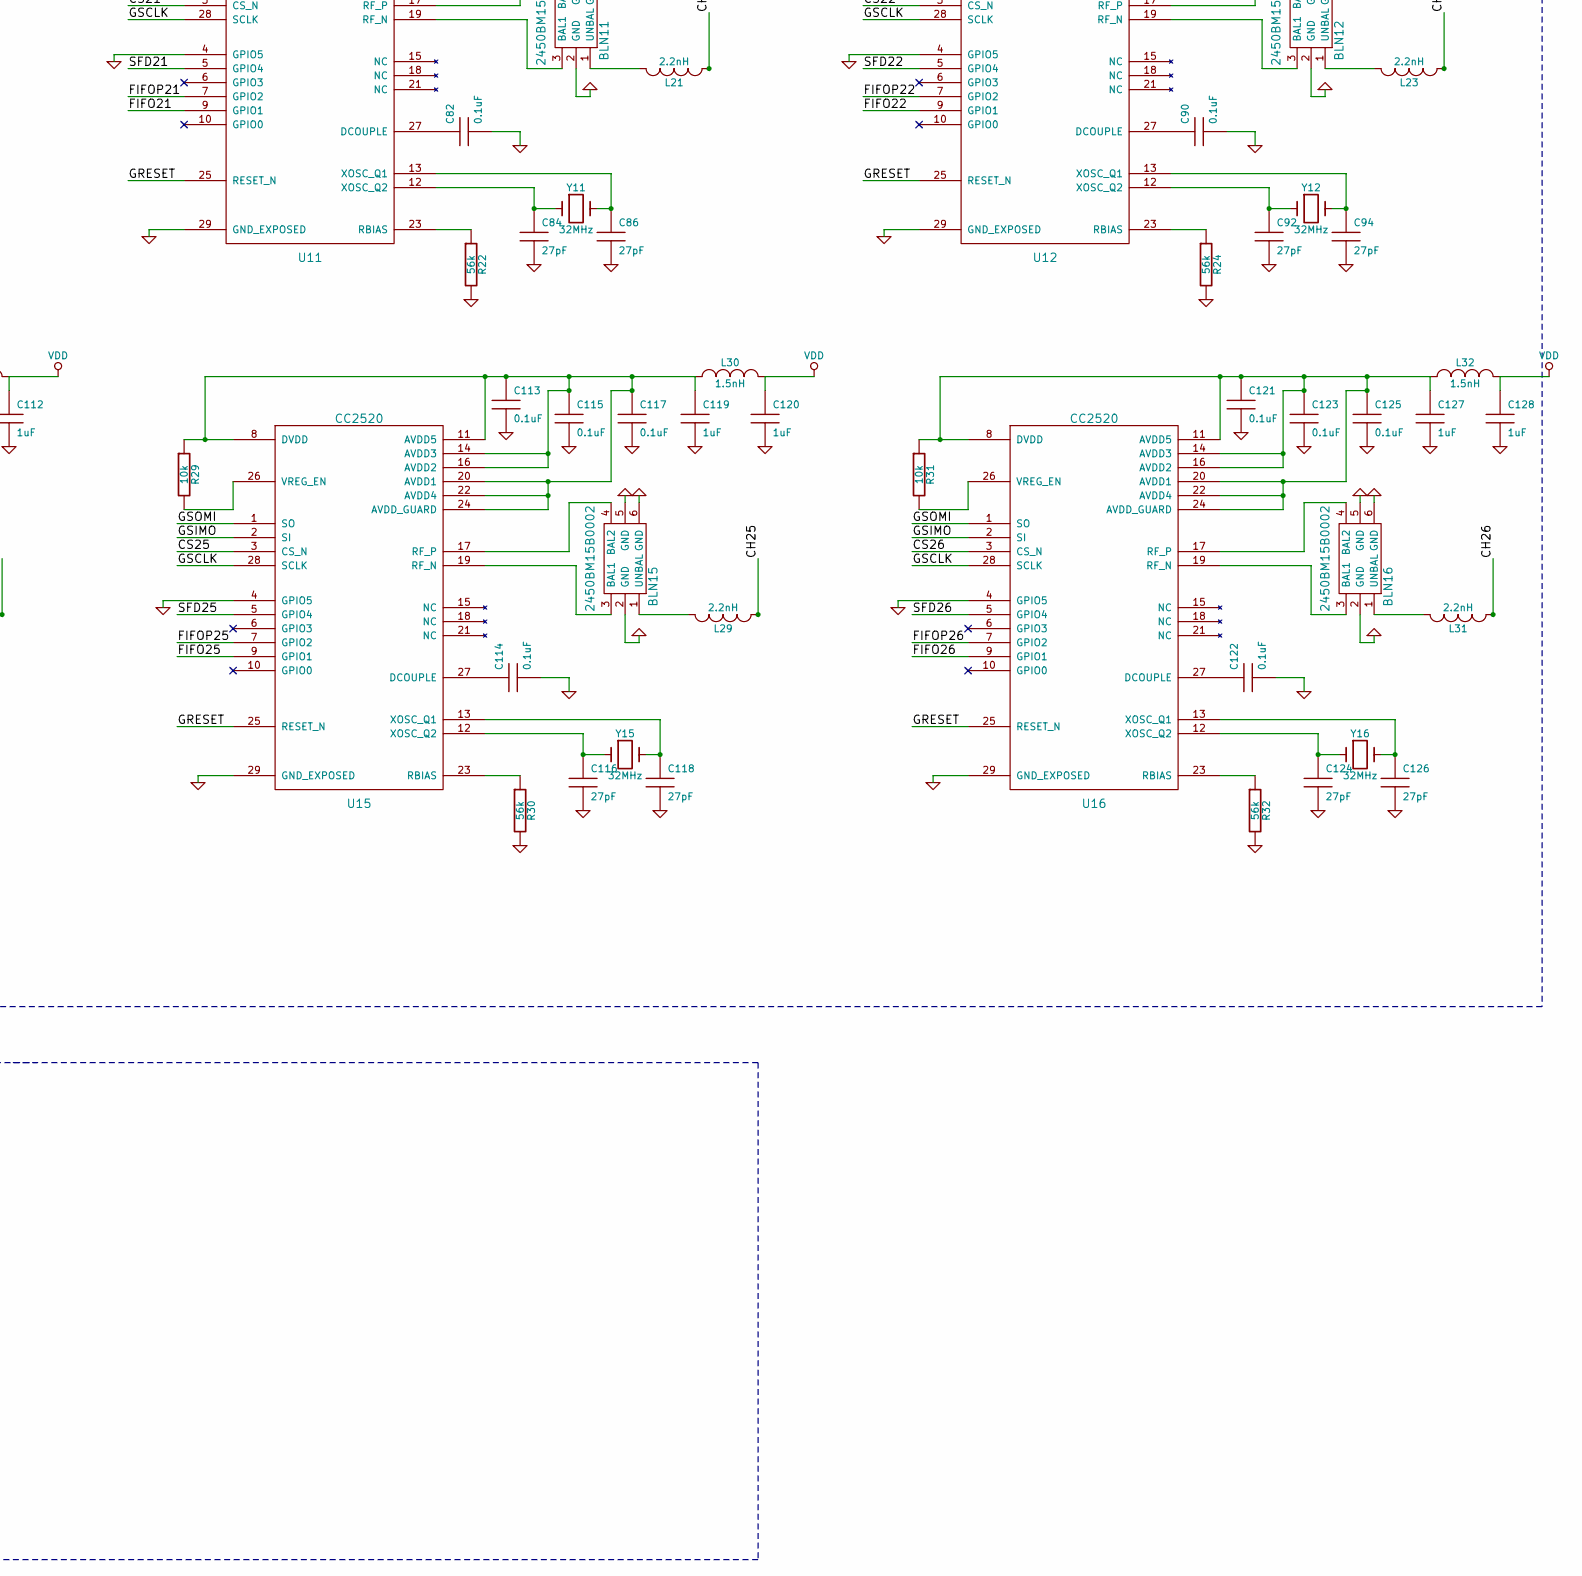
[picture p33: schematic hdme.sch, part in row 2, column 2]

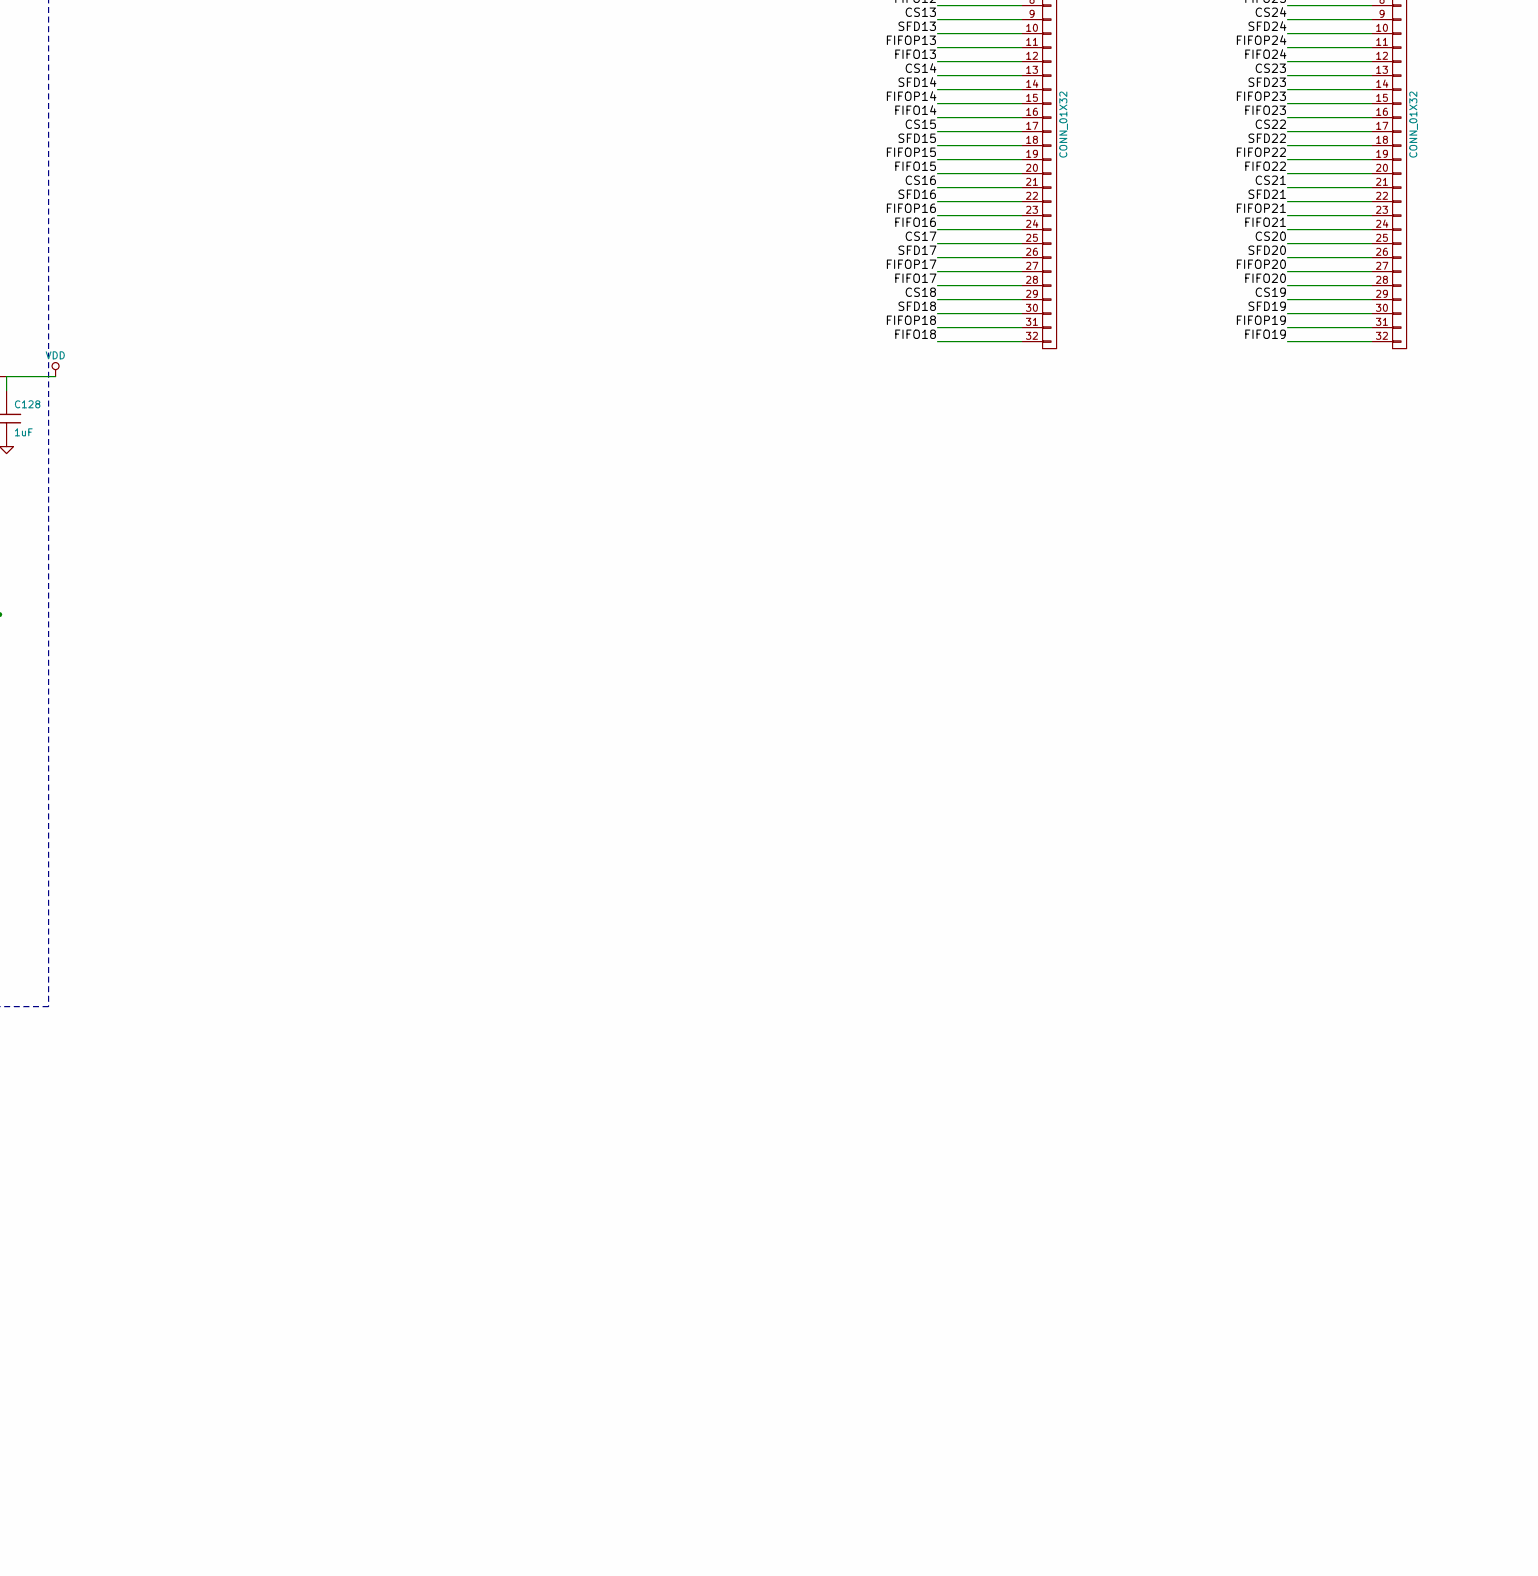
[picture p34: schematic hdme.sch, part in row 2, column 3]

Parts:
ANT2: CON-SMA; SMA
BLN1, BLN2, BLN3, BLN4, BLN5, BLN6, BLN7, BLN8, BLN9, BLN10, BLN11, BLN12, BLN13, BLN14, BLN15, BLN16: 2450BM15B0002; FinalBalun
C1, C2, C3, C5, C9, C10, C11, C13, C17, C18, C19, C21, C25, C26, C27, C29, C33, C34, C35, C37, C41, C42, C43, C45, C49, C50, C51, C53, C57, C58, C59, C61, C65, C66, C67, C69, C73, C74, C75, C77, C81, C82, C83, C85, C89, C90, C91, C93, C97, C98, C99, C101, C105, C106, C107, C109, C113, C114, C115, C117, C121, C122, C123, C125: 0.1uF; C_0402
C4, C6, C12, C14, C20, C22, C28, C30, C36, C38, C44, C46, C52, C54, C60, C62, C68, C70, C76, C78, C84, C86, C92, C94, C100, C102, C108, C110, C116, C118, C124, C126: 27pF; C_0402
C7, C8, C15, C16, C23, C24, C31, C32, C39, C40, C47, C48, C55, C56, C63, C64, C71, C72, C79, C80, C87, C88, C95, C96, C103, C104, C111, C112, C119, C120, C127, C128: 1uF; C_0402
L1, L3, L5, L7, L9, L11, L13, L15, L17, L19, L21, L23, L25, L27, L29, L31: 2.2nH; C_0402
L2, L4, L6, L8, L10, L12, L14, L16, L18, L20, L22, L24, L26, L28, L30, L32: 1.5nH; C_0402
P1, P2: CONN_01X32; Pin_Header_Straight_1x32
R1, R3, R5, R7, R9, R11, R13, R15, R17, R19, R21, R23, R25, R27, R29, R31: 10k; R_0402
R2, R4, R6, R8, R10, R12, R14, R16, R18, R20, R22, R24, R26, R28, R30, R32: 56k; R_0402
U1, U2, U3, U4, U5, U6, U7, U8, U9, U10, U11, U12, U13, U14, U15, U16: CC2520; QFN-28-1EP_5x5mm_Pitch0.5mm
U18, U19, U20, U21, U22: BP4U+; BP4u+
Y1, Y2, Y3, Y4, Y5, Y6, Y7, Y8, Y9, Y10, Y11, Y12, Y13, Y14, Y15, Y16: 32MHz; Crystal_HC49-SD_SMD

Connections:
CH11: L1.2, U18.1 (PORT1)
CH12: L3.2, U18.8 (PORT2)
CH13: L5.2, U18.5 (PORT3)
CH14: L7.2, U18.4 (PORT4)
CH15: L9.2, U19.1 (PORT1)
CH16: L11.2, U19.8 (PORT2)
CH17: L13.2, U19.5 (PORT3)
CH18: L15.2, U19.4 (PORT4)
CH19: L17.2, U20.1 (PORT1)
CH20: L19.2, U20.8 (PORT2)
CH21: L21.2, U20.5 (PORT3)
CH22: L23.2, U20.4 (PORT4)
CH23: L25.2, U21.1 (PORT1)
CH24: L27.2, U21.8 (PORT2)
CH25: L29.2, U21.5 (PORT3)
CH26: L31.2, U21.4 (PORT4)
CS11: P1.1, U1.3 (CS_N)
CS12: P1.5, U2.3 (CS_N)
CS13: P1.9, U3.3 (CS_N)
CS14: P1.13, U4.3 (CS_N)
CS15: P1.17, U5.3 (CS_N)
CS16: P1.21, U6.3 (CS_N)
CS17: P1.25, U7.3 (CS_N)
CS18: P1.29, U8.3 (CS_N)
CS19: P2.29, U9.3 (CS_N)
CS20: P2.25, U10.3 (CS_N)
CS21: P2.21, U11.3 (CS_N)
CS22: P2.17, U12.3 (CS_N)
CS23: P2.13, U13.3 (CS_N)
CS24: P2.9, U14.3 (CS_N)
CS25: P2.5, U15.3 (CS_N)
CS26: P2.1, U16.3 (CS_N)
FIFO11: P1.4, U1.9 (GPIO1)
FIFO12: P1.8, U2.9 (GPIO1)
FIFO13: P1.12, U3.9 (GPIO1)
FIFO14: P1.16, U4.9 (GPIO1)
FIFO15: P1.20, U5.9 (GPIO1)
FIFO16: P1.24, U6.9 (GPIO1)
FIFO17: P1.28, U7.9 (GPIO1)
FIFO18: P1.32, U8.9 (GPIO1)
FIFO19: P2.32, U9.9 (GPIO1)
FIFO20: P2.28, U10.9 (GPIO1)
FIFO21: P2.24, U11.9 (GPIO1)
FIFO22: P2.20, U12.9 (GPIO1)
FIFO23: P2.16, U13.9 (GPIO1)
FIFO24: P2.12, U14.9 (GPIO1)
FIFO25: P2.8, U15.9 (GPIO1)
FIFO26: P2.4, U16.9 (GPIO1)
FIFOP11: P1.3, U1.7 (GPIO2)
FIFOP12: P1.7, U2.7 (GPIO2)
FIFOP13: P1.11, U3.7 (GPIO2)
FIFOP14: P1.15, U4.7 (GPIO2)
FIFOP15: P1.19, U5.7 (GPIO2)
FIFOP16: P1.23, U6.7 (GPIO2)
FIFOP17: P1.27, U7.7 (GPIO2)
FIFOP18: P1.31, U8.7 (GPIO2)
FIFOP19: P2.31, U9.7 (GPIO2)
FIFOP20: P2.27, U10.7 (GPIO2)
FIFOP21: P2.23, U11.7 (GPIO2)
FIFOP22: P2.19, U12.7 (GPIO2)
FIFOP23: P2.15, U13.7 (GPIO2)
FIFOP24: P2.11, U14.7 (GPIO2)
FIFOP25: P2.7, U15.7 (GPIO2)
FIFOP26: P2.3, U16.7 (GPIO2)
GND: ANT2.2 (GND), ANT2.3 (GND), ANT2.4 (GND), ANT2.5 (GND), BLN1.2 (GND), BLN1.5 (GND), BLN1.6 (GND), BLN2.2 (GND), BLN2.5 (GND), BLN2.6 (GND), BLN3.2 (GND), BLN3.5 (GND), BLN3.6 (GND), BLN4.2 (GND), BLN4.5 (GND), BLN4.6 (GND), BLN5.2 (GND), BLN5.5 (GND), BLN5.6 (GND), BLN6.2 (GND), BLN6.5 (GND), BLN6.6 (GND), BLN7.2 (GND), BLN7.5 (GND), BLN7.6 (GND), BLN8.2 (GND), BLN8.5 (GND), BLN8.6 (GND), BLN9.2 (GND), BLN9.5 (GND), BLN9.6 (GND), BLN10.2 (GND), BLN10.5 (GND), BLN10.6 (GND), BLN11.2 (GND), BLN11.5 (GND), BLN11.6 (GND), BLN12.2 (GND), BLN12.5 (GND), BLN12.6 (GND), BLN13.2 (GND), BLN13.5 (GND), BLN13.6 (GND), BLN14.2 (GND), BLN14.5 (GND), BLN14.6 (GND), BLN15.2 (GND), BLN15.5 (GND), BLN15.6 (GND), BLN16.2 (GND), BLN16.5 (GND), BLN16.6 (GND), C1.2, C2.2, C3.2, C4.2, C5.2, C6.2, C7.2, C8.2, C9.2, C10.2, C11.2, C12.2, C13.2, C14.2, C15.2, C16.2, C17.2, C18.2, C19.2, C20.2, C21.2, C22.2, C23.2, C24.2, C25.2, C26.2, C27.2, C28.2, C29.2, C30.2, C31.2, C32.2, C33.2, C34.2, C35.2, C36.2, C37.2, C38.2, C39.2, C40.2, C41.2, C42.2, C43.2, C44.2, C45.2, C46.2, C47.2, C48.2, C49.2, C50.2, C51.2, C52.2, C53.2, C54.2, C55.2, C56.2, C57.2, C58.2, C59.2, C60.2, C61.2, C62.2, C63.2, C64.2, C65.2, C66.2, C67.2, C68.2, C69.2, C70.2, C71.2, C72.2, C73.2, C74.2, C75.2, C76.2, C77.2, C78.2, C79.2, C80.2, C81.2, C82.2, C83.2, C84.2, C85.2, C86.2, C87.2, C88.2, C89.2, C90.2, C91.2, C92.2, C93.2, C94.2, C95.2, C96.2, C97.2, C98.2, C99.2, C100.2, C101.2, C102.2, C103.2, C104.2, C105.2, C106.2, C107.2, C108.2, C109.2, C110.2, C111.2, C112.2, C113.2, C114.2, C115.2, C116.2, C117.2, C118.2, C119.2, C120.2, C121.2, C122.2, C123.2, C124.2, C125.2, C126.2, C127.2, C128.2, R2.2, R4.2, R6.2, R8.2, R10.2, R12.2, R14.2, R16.2, R18.2, R20.2, R22.2, R24.2, R26.2, R28.2, R30.2, R32.2, U1.4 (GPIO5), U1.29 (GND_EXPOSED), U2.4 (GPIO5), U2.29 (GND_EXPOSED), U3.4 (GPIO5), U3.29 (GND_EXPOSED), U4.4 (GPIO5), U4.29 (GND_EXPOSED), U5.4 (GPIO5), U5.29 (GND_EXPOSED), U6.4 (GPIO5), U6.29 (GND_EXPOSED), U7.4 (GPIO5), U7.29 (GND_EXPOSED), U8.4 (GPIO5), U8.29 (GND_EXPOSED), U9.4 (GPIO5), U9.29 (GND_EXPOSED), U10.4 (GPIO5), U10.29 (GND_EXPOSED), U11.4 (GPIO5), U11.29 (GND_EXPOSED), U12.4 (GPIO5), U12.29 (GND_EXPOSED), U13.4 (GPIO5), U13.29 (GND_EXPOSED), U14.4 (GPIO5), U14.29 (GND_EXPOSED), U15.4 (GPIO5), U15.29 (GND_EXPOSED), U16.4 (GPIO5), U16.29 (GND_EXPOSED), U18.3 (GND), U18.6 (GND), U18.7 (GND), U19.3 (GND), U19.6 (GND), U19.7 (GND), U20.3 (GND), U20.6 (GND), U20.7 (GND), U21.3 (GND), U21.6 (GND), U21.7 (GND), U22.3 (GND), U22.6 (GND), U22.7 (GND)
GRESET: U1.25 (RESET_N), U2.25 (RESET_N), U3.25 (RESET_N), U4.25 (RESET_N), U5.25 (RESET_N), U6.25 (RESET_N), U7.25 (RESET_N), U8.25 (RESET_N), U9.25 (RESET_N), U10.25 (RESET_N), U11.25 (RESET_N), U12.25 (RESET_N), U13.25 (RESET_N), U14.25 (RESET_N), U15.25 (RESET_N), U16.25 (RESET_N)
GSCLK: U1.28 (SCLK), U2.28 (SCLK), U3.28 (SCLK), U4.28 (SCLK), U5.28 (SCLK), U6.28 (SCLK), U7.28 (SCLK), U8.28 (SCLK), U9.28 (SCLK), U10.28 (SCLK), U11.28 (SCLK), U12.28 (SCLK), U13.28 (SCLK), U14.28 (SCLK), U15.28 (SCLK), U16.28 (SCLK)
GSIMO: U1.2 (SI), U2.2 (SI), U3.2 (SI), U4.2 (SI), U5.2 (SI), U6.2 (SI), U7.2 (SI), U8.2 (SI), U9.2 (SI), U10.2 (SI), U11.2 (SI), U12.2 (SI), U13.2 (SI), U14.2 (SI), U15.2 (SI), U16.2 (SI)
GSOMI: U1.1 (SO), U2.1 (SO), U3.1 (SO), U4.1 (SO), U5.1 (SO), U6.1 (SO), U7.1 (SO), U8.1 (SO), U9.1 (SO), U10.1 (SO), U11.1 (SO), U12.1 (SO), U13.1 (SO), U14.1 (SO), U15.1 (SO), U16.1 (SO)
unnamed: ANT2.1 (SMA), U22.2 (SUMPORT)
unnamed: BLN1.1 (UNBAL), L1.1
unnamed: BLN1.3 (BAL1), U1.19 (RF_N)
unnamed: BLN1.4 (BAL2), U1.17 (RF_P)
unnamed: BLN2.1 (UNBAL), L3.1
unnamed: BLN2.3 (BAL1), U2.19 (RF_N)
unnamed: BLN2.4 (BAL2), U2.17 (RF_P)
unnamed: BLN3.1 (UNBAL), L5.1
unnamed: BLN3.3 (BAL1), U3.19 (RF_N)
unnamed: BLN3.4 (BAL2), U3.17 (RF_P)
unnamed: BLN4.1 (UNBAL), L7.1
unnamed: BLN4.3 (BAL1), U4.19 (RF_N)
unnamed: BLN4.4 (BAL2), U4.17 (RF_P)
unnamed: BLN5.1 (UNBAL), L9.1
unnamed: BLN5.3 (BAL1), U5.19 (RF_N)
unnamed: BLN5.4 (BAL2), U5.17 (RF_P)
unnamed: BLN6.1 (UNBAL), L11.1
unnamed: BLN6.3 (BAL1), U6.19 (RF_N)
unnamed: BLN6.4 (BAL2), U6.17 (RF_P)
unnamed: BLN7.1 (UNBAL), L13.1
unnamed: BLN7.3 (BAL1), U7.19 (RF_N)
unnamed: BLN7.4 (BAL2), U7.17 (RF_P)
unnamed: BLN8.1 (UNBAL), L15.1
unnamed: BLN8.3 (BAL1), U8.19 (RF_N)
unnamed: BLN8.4 (BAL2), U8.17 (RF_P)
unnamed: BLN9.1 (UNBAL), L17.1
unnamed: BLN9.3 (BAL1), U9.19 (RF_N)
unnamed: BLN9.4 (BAL2), U9.17 (RF_P)
unnamed: BLN10.1 (UNBAL), L19.1
unnamed: BLN10.3 (BAL1), U10.19 (RF_N)
unnamed: BLN10.4 (BAL2), U10.17 (RF_P)
unnamed: BLN11.1 (UNBAL), L21.1
unnamed: BLN11.3 (BAL1), U11.19 (RF_N)
unnamed: BLN11.4 (BAL2), U11.17 (RF_P)
unnamed: BLN12.1 (UNBAL), L23.1
unnamed: BLN12.3 (BAL1), U12.19 (RF_N)
unnamed: BLN12.4 (BAL2), U12.17 (RF_P)
unnamed: BLN13.1 (UNBAL), L25.1
unnamed: BLN13.3 (BAL1), U13.19 (RF_N)
unnamed: BLN13.4 (BAL2), U13.17 (RF_P)
unnamed: BLN14.1 (UNBAL), L27.1
unnamed: BLN14.3 (BAL1), U14.19 (RF_N)
unnamed: BLN14.4 (BAL2), U14.17 (RF_P)
unnamed: BLN15.1 (UNBAL), L29.1
unnamed: BLN15.3 (BAL1), U15.19 (RF_N)
unnamed: BLN15.4 (BAL2), U15.17 (RF_P)
unnamed: BLN16.1 (UNBAL), L31.1
unnamed: BLN16.3 (BAL1), U16.19 (RF_N)
unnamed: BLN16.4 (BAL2), U16.17 (RF_P)
unnamed: C1.1, C3.1, C5.1, C7.1, L2.1, R1.1, U1.8 (DVDD), U1.11 (AVDD5), U1.14 (AVDD3), U1.16 (AVDD2), U1.20 (AVDD1), U1.22 (AVDD4), U1.24 (AVDD_GUARD)
unnamed: C2.1, U1.27 (DCOUPLE)
unnamed: C4.1, U1.12 (XOSC_Q2), Y1.1
unnamed: C6.1, U1.13 (XOSC_Q1), Y1.2
unnamed: C10.1, U2.27 (DCOUPLE)
unnamed: C9.1, C11.1, C13.1, C15.1, L4.1, R3.1, U2.8 (DVDD), U2.11 (AVDD5), U2.14 (AVDD3), U2.16 (AVDD2), U2.20 (AVDD1), U2.22 (AVDD4), U2.24 (AVDD_GUARD)
unnamed: C12.1, U2.12 (XOSC_Q2), Y2.1
unnamed: C14.1, U2.13 (XOSC_Q1), Y2.2
unnamed: C17.1, C19.1, C21.1, C23.1, L6.1, R5.1, U3.8 (DVDD), U3.11 (AVDD5), U3.14 (AVDD3), U3.16 (AVDD2), U3.20 (AVDD1), U3.22 (AVDD4), U3.24 (AVDD_GUARD)
unnamed: C18.1, U3.27 (DCOUPLE)
unnamed: C20.1, U3.12 (XOSC_Q2), Y3.1
unnamed: C22.1, U3.13 (XOSC_Q1), Y3.2
unnamed: C25.1, C27.1, C29.1, C31.1, L8.1, R7.1, U4.8 (DVDD), U4.11 (AVDD5), U4.14 (AVDD3), U4.16 (AVDD2), U4.20 (AVDD1), U4.22 (AVDD4), U4.24 (AVDD_GUARD)
unnamed: C26.1, U4.27 (DCOUPLE)
unnamed: C28.1, U4.12 (XOSC_Q2), Y4.1
unnamed: C30.1, U4.13 (XOSC_Q1), Y4.2
unnamed: C33.1, C35.1, C37.1, C39.1, L10.1, R9.1, U5.8 (DVDD), U5.11 (AVDD5), U5.14 (AVDD3), U5.16 (AVDD2), U5.20 (AVDD1), U5.22 (AVDD4), U5.24 (AVDD_GUARD)
unnamed: C34.1, U5.27 (DCOUPLE)
unnamed: C36.1, U5.12 (XOSC_Q2), Y5.1
unnamed: C38.1, U5.13 (XOSC_Q1), Y5.2
unnamed: C41.1, C43.1, C45.1, C47.1, L12.1, R11.1, U6.8 (DVDD), U6.11 (AVDD5), U6.14 (AVDD3), U6.16 (AVDD2), U6.20 (AVDD1), U6.22 (AVDD4), U6.24 (AVDD_GUARD)
unnamed: C42.1, U6.27 (DCOUPLE)
unnamed: C44.1, U6.12 (XOSC_Q2), Y6.1
unnamed: C46.1, U6.13 (XOSC_Q1), Y6.2
unnamed: C49.1, C51.1, C53.1, C55.1, L14.1, R13.1, U7.8 (DVDD), U7.11 (AVDD5), U7.14 (AVDD3), U7.16 (AVDD2), U7.20 (AVDD1), U7.22 (AVDD4), U7.24 (AVDD_GUARD)
unnamed: C50.1, U7.27 (DCOUPLE)
unnamed: C52.1, U7.12 (XOSC_Q2), Y7.1
unnamed: C54.1, U7.13 (XOSC_Q1), Y7.2
unnamed: C57.1, C59.1, C61.1, C63.1, L16.1, R15.1, U8.8 (DVDD), U8.11 (AVDD5), U8.14 (AVDD3), U8.16 (AVDD2), U8.20 (AVDD1), U8.22 (AVDD4), U8.24 (AVDD_GUARD)
unnamed: C58.1, U8.27 (DCOUPLE)
unnamed: C60.1, U8.12 (XOSC_Q2), Y8.1
unnamed: C62.1, U8.13 (XOSC_Q1), Y8.2
unnamed: C65.1, C67.1, C69.1, C71.1, L18.1, R17.1, U9.8 (DVDD), U9.11 (AVDD5), U9.14 (AVDD3), U9.16 (AVDD2), U9.20 (AVDD1), U9.22 (AVDD4), U9.24 (AVDD_GUARD)
unnamed: C66.1, U9.27 (DCOUPLE)
unnamed: C68.1, U9.12 (XOSC_Q2), Y9.1
unnamed: C70.1, U9.13 (XOSC_Q1), Y9.2
unnamed: C73.1, C75.1, C77.1, C79.1, L20.1, R19.1, U10.8 (DVDD), U10.11 (AVDD5), U10.14 (AVDD3), U10.16 (AVDD2), U10.20 (AVDD1), U10.22 (AVDD4), U10.24 (AVDD_GUARD)
unnamed: C74.1, U10.27 (DCOUPLE)
unnamed: C76.1, U10.12 (XOSC_Q2), Y10.1
unnamed: C78.1, U10.13 (XOSC_Q1), Y10.2
unnamed: C81.1, C83.1, C85.1, C87.1, L22.1, R21.1, U11.8 (DVDD), U11.11 (AVDD5), U11.14 (AVDD3), U11.16 (AVDD2), U11.20 (AVDD1), U11.22 (AVDD4), U11.24 (AVDD_GUARD)
unnamed: C82.1, U11.27 (DCOUPLE)
unnamed: C84.1, U11.12 (XOSC_Q2), Y11.1
unnamed: C86.1, U11.13 (XOSC_Q1), Y11.2
unnamed: C89.1, C91.1, C93.1, C95.1, L24.1, R23.1, U12.8 (DVDD), U12.11 (AVDD5), U12.14 (AVDD3), U12.16 (AVDD2), U12.20 (AVDD1), U12.22 (AVDD4), U12.24 (AVDD_GUARD)
unnamed: C90.1, U12.27 (DCOUPLE)
unnamed: C92.1, U12.12 (XOSC_Q2), Y12.1
unnamed: C94.1, U12.13 (XOSC_Q1), Y12.2
unnamed: C98.1, U13.27 (DCOUPLE)
unnamed: C100.1, U13.12 (XOSC_Q2), Y13.1
unnamed: C97.1, C99.1, C101.1, C103.1, L26.1, R25.1, U13.8 (DVDD), U13.11 (AVDD5), U13.14 (AVDD3), U13.16 (AVDD2), U13.20 (AVDD1), U13.22 (AVDD4), U13.24 (AVDD_GUARD)
unnamed: C102.1, U13.13 (XOSC_Q1), Y13.2
unnamed: C105.1, C107.1, C109.1, C111.1, L28.1, R27.1, U14.8 (DVDD), U14.11 (AVDD5), U14.14 (AVDD3), U14.16 (AVDD2), U14.20 (AVDD1), U14.22 (AVDD4), U14.24 (AVDD_GUARD)
unnamed: C106.1, U14.27 (DCOUPLE)
unnamed: C108.1, U14.12 (XOSC_Q2), Y14.1
unnamed: C110.1, U14.13 (XOSC_Q1), Y14.2
unnamed: C113.1, C115.1, C117.1, C119.1, L30.1, R29.1, U15.8 (DVDD), U15.11 (AVDD5), U15.14 (AVDD3), U15.16 (AVDD2), U15.20 (AVDD1), U15.22 (AVDD4), U15.24 (AVDD_GUARD)
unnamed: C114.1, U15.27 (DCOUPLE)
unnamed: C116.1, U15.12 (XOSC_Q2), Y15.1
unnamed: C118.1, U15.13 (XOSC_Q1), Y15.2
unnamed: C121.1, C123.1, C125.1, C127.1, L32.1, R31.1, U16.8 (DVDD), U16.11 (AVDD5), U16.14 (AVDD3), U16.16 (AVDD2), U16.20 (AVDD1), U16.22 (AVDD4), U16.24 (AVDD_GUARD)
unnamed: C122.1, U16.27 (DCOUPLE)
unnamed: C124.1, U16.12 (XOSC_Q2), Y16.1
unnamed: C126.1, U16.13 (XOSC_Q1), Y16.2
unnamed: R1.2, U1.26 (VREG_EN)
unnamed: R2.1, U1.23 (RBIAS)
unnamed: R3.2, U2.26 (VREG_EN)
unnamed: R4.1, U2.23 (RBIAS)
unnamed: R5.2, U3.26 (VREG_EN)
unnamed: R6.1, U3.23 (RBIAS)
unnamed: R7.2, U4.26 (VREG_EN)
unnamed: R8.1, U4.23 (RBIAS)
unnamed: R9.2, U5.26 (VREG_EN)
unnamed: R10.1, U5.23 (RBIAS)
unnamed: R11.2, U6.26 (VREG_EN)
unnamed: R12.1, U6.23 (RBIAS)
unnamed: R13.2, U7.26 (VREG_EN)
unnamed: R14.1, U7.23 (RBIAS)
unnamed: R15.2, U8.26 (VREG_EN)
unnamed: R16.1, U8.23 (RBIAS)
unnamed: R17.2, U9.26 (VREG_EN)
unnamed: R18.1, U9.23 (RBIAS)
unnamed: R19.2, U10.26 (VREG_EN)
unnamed: R20.1, U10.23 (RBIAS)
unnamed: R21.2, U11.26 (VREG_EN)
unnamed: R22.1, U11.23 (RBIAS)
unnamed: R23.2, U12.26 (VREG_EN)
unnamed: R24.1, U12.23 (RBIAS)
unnamed: R25.2, U13.26 (VREG_EN)
unnamed: R26.1, U13.23 (RBIAS)
unnamed: R27.2, U14.26 (VREG_EN)
unnamed: R28.1, U14.23 (RBIAS)
unnamed: R29.2, U15.26 (VREG_EN)
unnamed: R30.1, U15.23 (RBIAS)
unnamed: R31.2, U16.26 (VREG_EN)
unnamed: R32.1, U16.23 (RBIAS)
unnamed: U18.2 (SUMPORT), U22.1 (PORT1)
unnamed: U19.2 (SUMPORT), U22.8 (PORT2)
unnamed: U20.2 (SUMPORT), U22.5 (PORT3)
unnamed: U21.2 (SUMPORT), U22.4 (PORT4)
SFD11: P1.2, U1.5 (GPIO4)
SFD12: P1.6, U2.5 (GPIO4)
SFD13: P1.10, U3.5 (GPIO4)
SFD14: P1.14, U4.5 (GPIO4)
SFD15: P1.18, U5.5 (GPIO4)
SFD16: P1.22, U6.5 (GPIO4)
SFD17: P1.26, U7.5 (GPIO4)
SFD18: P1.30, U8.5 (GPIO4)
SFD19: P2.30, U9.5 (GPIO4)
SFD20: P2.26, U10.5 (GPIO4)
SFD21: P2.22, U11.5 (GPIO4)
SFD22: P2.18, U12.5 (GPIO4)
SFD23: P2.14, U13.5 (GPIO4)
SFD24: P2.10, U14.5 (GPIO4)
SFD25: P2.6, U15.5 (GPIO4)
SFD26: P2.2, U16.5 (GPIO4)
VDD: C8.1, C16.1, C24.1, C32.1, C40.1, C48.1, C56.1, C64.1, C72.1, C80.1, C88.1, C96.1, C104.1, C112.1, C120.1, C128.1, L2.2, L4.2, L6.2, L8.2, L10.2, L12.2, L14.2, L16.2, L18.2, L20.2, L22.2, L24.2, L26.2, L28.2, L30.2, L32.2

Notes on the sheet:
Pin Key: GSOMI: Global Slave-Out Master-In line GSIMO: Global Slave-In Master-Out line FIFOn: RX buffer not empty signal, channel n FIFOPn: RX buffer full signal, channel n SFDn: Start frame delimeter signal, channel n CHn: RF signal from antenna, channel n CSn: Clock Select RX line, channel n GRES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
RSW-2-25PA+ design reference http://www.minicircuits.com/MCLStore/dashboardPdf model=RSW-2-25PA%2B
VCOM power ports require 5V, all others can take 3.3-3.6
