tomx4096/hexidecimote/(commit log)

2016-08-08 kicad design files
    [hdme-B.Cu.gbr, hdme-B.Mask.gbr, hdme-B.Paste.gbr, hdme-B.SilkS.gbr, hdme-Edge.Cuts.gbr, hdme-F.Adhes.gbr, hdme-F.Cu.gbr, hdme-F.Mask.gbr]
2016-08-08 slideshow from dc24 wireless village talk
2016-08-08 bill of materials
    [bom.csv]
